darwinbeing/tesc/README.md

VESC – Open Source ESC
=============

This the Hardware for my open source custom ESC.

[//]: # (Image References)
[image1]: design/PNGs/VESC_6_top.png "MB Front"
[image2]: design/PNGs/VESC_6_bottom.png "MB Back"

## 3D views
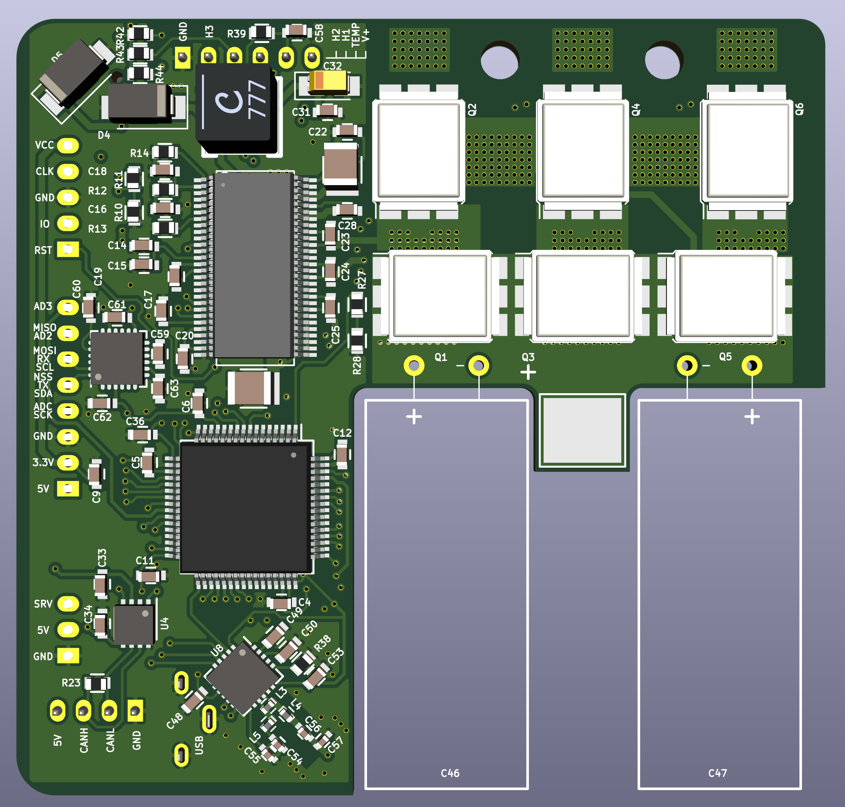
[picture p1: design/PNGs/VESC_6_top.png]

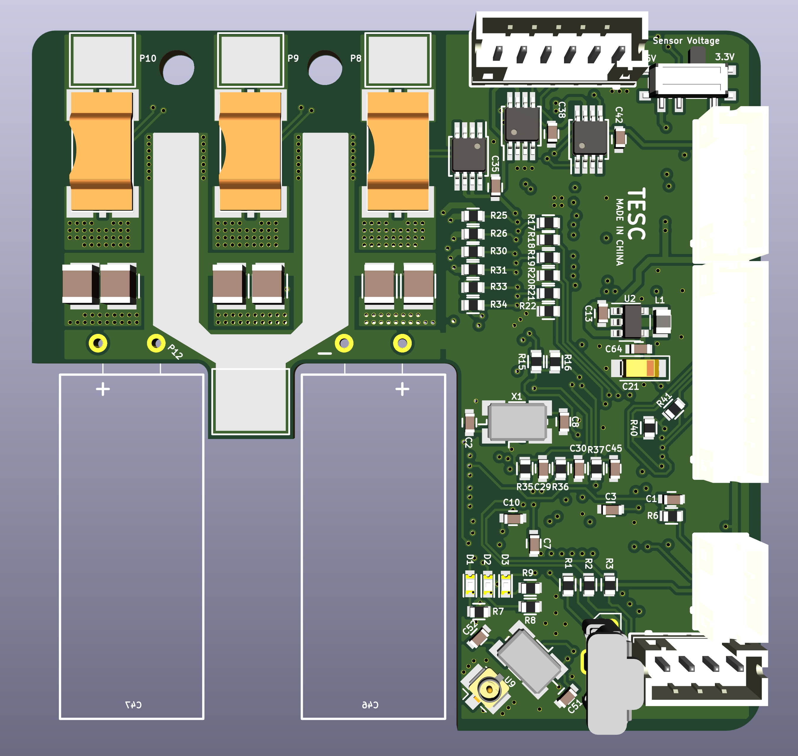
[picture p2: design/PNGs/VESC_6_bottom.png]
