darwinbeing/tesc/design/PNGs/VESC_6_plus_bottom.png

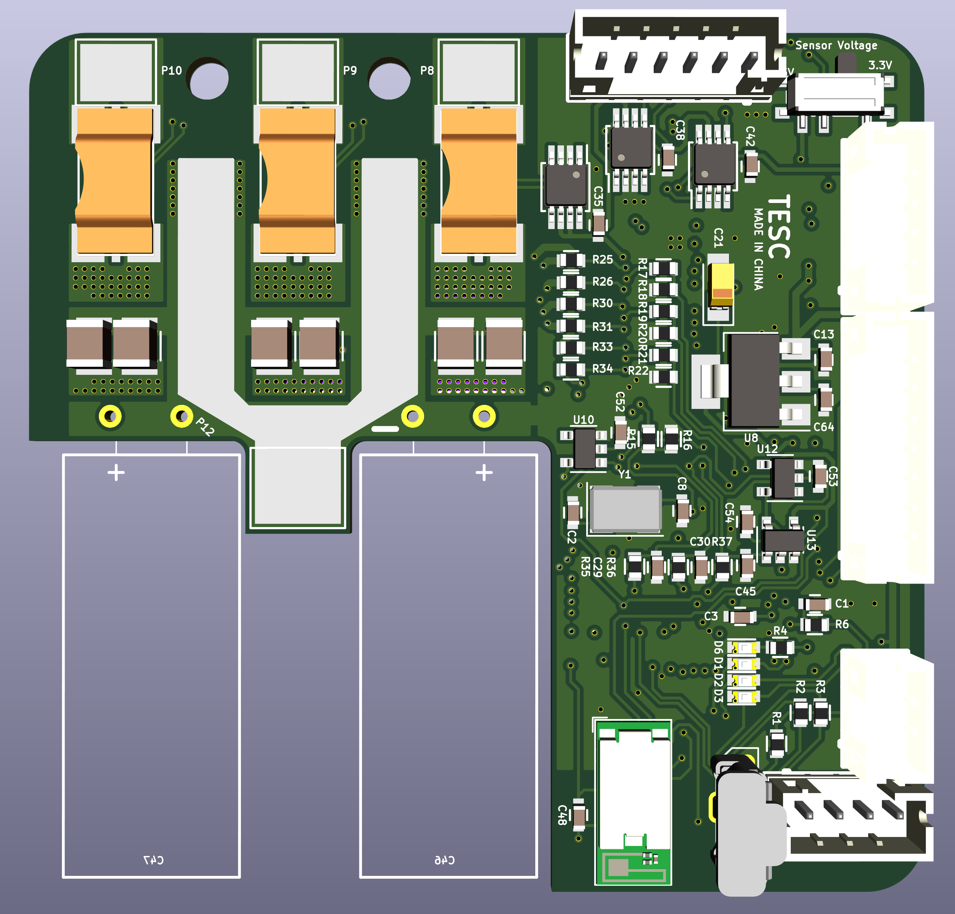
design/PNGs/VESC_6_plus_bottom.png
