darwinbeing/tesc/design/PNGs/VESC_6_plus_top.png

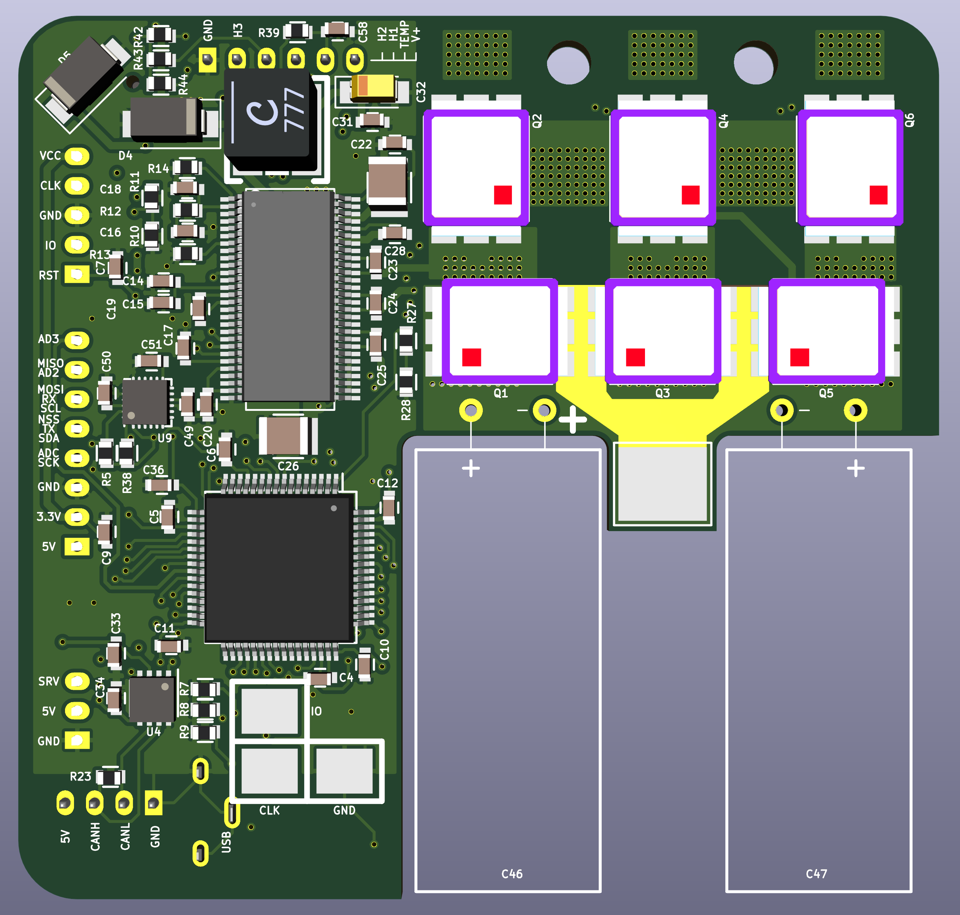
design/PNGs/VESC_6_plus_top.png
