darwinbeing/tesc/design/TESC Bill of Materials.xlsx

Reference | Value | Package | Description | Qty | Digikey | Mouser | Farnell | Arrow | Part Number |  | Place (YES/MotionTracking/Wireless)
U1 |  | LQFP-64 | STM32F4 MCU | 1 | 497-11767-ND | 511-STM32F405RGT6 | 2064363 | STM32F405RGT6 (https://www.arrow.com/en/products/stm32f405rgt6/stmicroelectronics) | STM32F405RGT6 |  | YES
U2 |  | SOT-23 | VREG LM3671 | 1 | LM3671MF-3.3/NOPBCT-ND | 926-LM3671MF-3.3NOPB | 1685767 | LM3671MF-3.3/NOPB (https://www.arrow.com/en/products/lm3671mf-3.3nopb/texas-instruments) | LM3671MF-3.3/NOPB |  | YES
U3 |  | HTSSOP-56-PP | MOSFET Driver DRV8301 | 1 | 296-33274-5-ND | 595-DRV8301DCA | 2057084 | DRV8301DCA (https://www.arrow.com/en/products/drv8301dca/texas-instruments) | DRV8301DCA |  | YES
U4 |  |  | CAN Trans TJA1051TK3 | 1 | 568-8686-1-ND | 771-TJA1051TK/3118 | 2776121 | TJA1051TK/3/1J (https://www.arrow.com/en/products/tja1051tk31j/nxp-semiconductors) | TJA1051TK/3/1J |  | YES
U5,U6,U7 |  | SOIC-8 | AD8418 | 3 | AD8418AWBRMZ-RLCT-ND | 584-AD8418AWBRMZ | 2383471 | AD8418AWBRMZ-RL (https://www.arrow.com/en/products/ad8418awbrmz-rl/analog-devices) | AD8418AWBRMZ |  | YES
U8 |  |  | nRF24L01+ | 1 | 1490-1019-ND | 949-NRF24L01P-T | 2842317 | NRF24L01P-T (https://www.arrow.com/en/products/nrf24l01p-t/nordic-semiconductor) | NRF24L01P-T | NRF24L01P-R7 | Wireless
U9 |  |  | CONN U FL antenna connector | 2 | H122041-ND | 798-UFLRSMT140 | 1688077 | U.FL-R-SMT-1(40) (https://www.arrow.com/en/products/u.fl-r-smt-1-40/hirose-electric) | U.FL-R-SMT-1(40) |  | Wireless
U10 |  |  | MPU9250 9-axis sensor | 1 | 1428-1019-1-ND | 410-MPU-9250 |  |  | MPU-9250 |  | MotionTracking
R27 |  | SM0603 | NTC resistor (temp sensor) | 1 | 490-4800-1-ND | 81-NCP18XH103F03RB | 2456122RL | NCP18XH103F03RB (https://www.arrow.com/en/products/ncp18xh103f03rb/murata-manufacturing) | NCP18XH103F03RB |  | YES
L1 | 2.2u | SMD0805 |  | 1 | 490-9573-1-ND |  |  | LQM21PN2R2MGHL (https://www.arrow.com/en/products/lqm21pn2r2mghl/murata-manufacturing) | LQM21PN2R2MGHL |  | YES
L2 | 22u | inductor_smd_8x8mm | Power Inductor | 1 | 732-3034-1-ND |  |  | SDR0805-220ML (https://www.arrow.com/en/products/sdr0805-220ml/bourns) | SDR0805-220ML | or SRN8040TA-220M | YES
L3 | 8.2n | SMD-0603 |  | 1 | 490-1109-1-ND |  |  | LQG18HN8N2J00D (https://www.arrow.com/en/products/lqg18hn8n2j00d/murata-manufacturing) | LQG18HN8N2J00D |  | Wireless
L4 | 3.9n | SMD-0603 |  | 1 | 490-1105-1-ND |  |  | LQG18HN3N9S00D (https://www.arrow.com/en/products/lqg18hn3n9s00d/murata-manufacturing) | LQG18HN3N9S00D |  | Wireless
L5 | 2.7n | SMD-0603 |  | 1 | 490-1103-1-ND |  |  | LQG18HN2N7S00D (https://www.arrow.com/en/products/lqg18hn2n7s00d/murata-manufacturing) | LQG18HN2N7S00D |  | Wireless
X1 | 8MHz |  | Crystal 8MHz, 10PPM | 1 | 535-9721-1-ND | 815-ABM3B-8.0-10-1UT |  | ABM3B-8.000MHZ-10-1-U-T (https://www.arrow.com/en/products/abm3b-8.000mhz-10-1-u-t/abracon) | ABM3B-8.000MHZ-10-1-U-T |  | YES
X2 | 16MHz |  | Crystal 16Mhz | 1 | 300-8206-1-ND | 815-ABM3B-16-T |  | ABM3B-16.000MHZ-10-1-U-T (https://www.arrow.com/en/products/abm3b-16.000mhz-10-1-u-t/abracon) | ABM3B-16.000MHZ-10-1-U-T |  | Wireless
Q1-Q6 |  | DIRECTFET L8 |  | 6 | IRF7749L2TRPBFCT-ND | 942-IRF7749L1TRPBF | 2725913 | IRF7749L1TRPBF (https://www.arrow.com/en/products/irf7749l1trpbf/infineon-technologies-ag) | IRF7749L1TRPBF | or IRF7749L2TRPBF | YES
R24,R29,R32 | 0.5mOhm |  | Shunt 0.5mOhm | 3 |  | 652-CSS2H3920RL500FE |  | CSS2H-3920R-L500FE (https://www.arrow.com/en/products/css2h-3920r-l500fe/bourns) | CSS2H-3920R-L500FE |  | YES
D5 | 5V | DO-214AC | TVS diode 5V | 1 |  | 576-SMAJ5.0A |  | SMAJ5.0A (https://www.arrow.com/en/products/smaj5.0a/littelfuse) | SMAJ5.0A |  | YES
D4 | 60V 2A | DO-214AA(SMB) | Shottky 60V 2A | 1 |  | 771-PMEG6020ER-115 |  | PMEG6020ER,115 (https://www.arrow.com/en/products/pmeg6020er115/nexperia) | PMEG6020ER,115 |  | YES
C1 C7 C28 C48 C49 C50 C53 C58 C60 | 100nF | Capacitors_SMD:C_0603 | 100nF 50V X7R 0603 | 9 | 478-5778-1-ND | 581-06035C104JAT2A | 1740621RL | 06035C104JAT2A (https://www.arrow.com/en/products/06035c104jat2a/avx) | 06035C104JAT2A
C2 C8 C51 C52 | 15pF | Capacitors_SMD:C_0603 | 15pF 100V C0G 0603 | 4 | 311-1749-1-ND | 603-CC603JRNPO0BN150 |  |  | CC0603JRNPO0BN150
C3 C4 C5 C6 C9 C10 C11 C12 C13 C14 C15 C17 C20 C31 C33 C34 C35 C36 C38 C42 C59 C61 C62 C63 C64 | 2.2uF | Capacitors_SMD:C_0603 | 2.2uF 16V X5R 0603 | 25 |  | 810-C1608X5R1C225M-4
C16 | 6.8nF | Capacitors_SMD:C_0603 | 6.8nF 50V X7R 0603 | 1 |  | 81-GRM18R71H682KA01J |  |  | GRT188R71H682KE01D
C18 | 120nF | Capacitors_SMD:C_0603 | 120nF 50V X7R 0603 | 1 |  | 81-GRM39C121J50 |  |  | GRM1885C1H121JA01D
C19 | 22nF | Capacitors_SMD:C_0603 | 22nF 50V X7R 0603 | 1 |  | 81-GCJ188L81H223KA1D
C21,C32 | 100uF, 6.3V | c_tant_B 1210 | CAP 100u, 6.3V | 2 |  | 581-TPSB107K006R0400 | 1432579 | TPSB107K006R0400 (https://www.arrow.com/en/products/tpsb107k006r0400/avx) | TPSB107K006R0400 |  | YES
C37,C39,C40,C41,C43,C44,C26,C27 | 4.7uF 100V | SMD1210 | CAP 4.7u, 100V, 1210 | 8 |  |  |  | C3225X7S2A475K200AB (https://www.arrow.com/en/products/c3225x7s2a475k200ab/tdk) | C3225X7S2A475K200AB |  | YES
C1,C7,C28,C58 | 100nF, 50V | SMD-0603 | CAP 100n, 50V, 0603 | 4 |  |  |  | 06035C104JAT2A (https://www.arrow.com/en/products/06035c104jat2a/avx) | 06035C104JAT2A |  | YES
C48,C49,C50,C53 | 100nF, 50V | SMD-0603 | CAP 100n, 50V, 0603 | 4 |  |  |  | 06035C104JAT2A (https://www.arrow.com/en/products/06035c104jat2a/avx) | 06035C104JAT2A |  | Wireless
C23,C24,C25 | 220nF,25V | SMD-0603 | CAP 220n, 25V, 0603 | 3 |  |  |  | CL10B224KA8NNNC (https://www.arrow.com/en/products/cl10b224ka8nnnc/samsung-electro-mechanics) | CL10B224KA8NNNC |  | YES
C3-C6,C9,C10,C11,C12,C13,C14,C15,C17,C20,C31,C33,C34,C35,C36,C38,C42,C64 | 2.2uF, 16V | SMD-0603 | CAP 2.2u, 16V, 0603 | 21 |  |  |  | CL10A225KO8NNNC (https://www.arrow.com/en/products/cl10a225ko8nnnc/samsung-electro-mechanics) | CL10A225KO8NNNC |  | YES
C59,C61,C62 | 2.2uF, 16V | SMD-0603 | CAP 2.2u, 16V, 0603 | 3 |  |  |  | CL10A225KO8NNNC (https://www.arrow.com/en/products/cl10a225ko8nnnc/samsung-electro-mechanics) | CL10A225KO8NNNC |  | MotionTracking
C29,C30,C45 | 4.7nF, 50V | SMD-0603 | CAP 4.7n, 50V, 0603 | 3 |  |  |  | GRM188R71H472JA01J (https://www.arrow.com/en/products/grm188r71h472ja01j/murata-manufacturing) | GRM188R71H472JA01J |  | YES
C54 | 2.2nF, 50V | SMD-0603 | CAP 2.2n, 50V, 0603 | 1 |  |  |  | GRM188R71H222JA01D (https://www.arrow.com/en/products/grm188r71h222ja01d/murata-manufacturing) | GRM188R71H222JA01D |  | Wireless
C2,C8 | 15pF, 100V | SMD-0603 | CAP 15p, 100V, 0603 | 2 |  |  |  | CC0603JRNPO0BN150 (https://www.arrow.com/en/products/cc0603jrnpo0bn150/yageo) | CC0603JRNPO0BN150 |  | YES
C51,C52 | 15pF, 100V | SMD-0603 | CAP 15p, 100V, 0603 | 2 |  |  |  | CC0603JRNPO0BN150 (https://www.arrow.com/en/products/cc0603jrnpo0bn150/yageo) | CC0603JRNPO0BN150 |  | Wireless
C18 | 120pF, 50V | SMD-0603 | CAP 120p, 50V, 0603 | 1 |  |  |  | GRM1885C1H121GA01D (https://www.arrow.com/en/products/grm1885c1h121ga01d/murata-manufacturing) | GRM1885C1H121GA01D |  | YES
C16 | 6.8nF, 50V | SMD-0603 | CAP 6.8n, 50V, 0603 | 1 |  |  |  | GRT188R71H682KE01D (https://www.arrow.com/en/products/grt188r71h682ke01d/murata-manufacturing) | GRT188R71H682KE01D |  | YES
C19 | 22nF, 50V | SMD-0603 | CAP 22n, 50V, 0603 | 1 |  |  |  | GRM188F51H223ZA01D (https://www.arrow.com/en/products/grm188f51h223za01d/murata-manufacturing) | GRM188F51H223ZA01D |  | YES
C22 | 15n, | SMD-0603 | CAP 15n, | 1 |  |  |  | VJ0603Y153KXACW1BC (https://www.arrow.com/en/products/vj0603y153kxacw1bc/vishay) | VJ0603Y153KXACW1BC |  | YES
C46,C47 | 680u, 63V | 30x12.5 mm | CAP 680u, 63V, | 2 |  | 661-EKZN630E681MK30S |  | EKZN630E681MK30S | EKZN630E681MK30S |  | YES
C55 | 4.7pF | SMD-0603 |  | 1 |  |  |  | CL10C4R7CB8NNND (https://www.arrow.com/en/products/cl10c4r7cb8nnnd/samsung-electro-mechanics) | CL10C4R7CB8NNND | solder on top of C54 | Wireless
C56 | 1.5pF | SMD-0603 |  | 1 |  |  |  | CL10C1R5BB8NNNC (https://www.arrow.com/en/products/cl10c1r5bb8nnnc/samsung-electro-mechanics) | CL10C1R5BB8NNNC |  | Wireless
C57 | 1pF | SM0603 |  | 1 |  |  |  | CL10C010BB8NNND (https://www.arrow.com/en/products/cl10c010bb8nnnd/samsung-electro-mechanics) | CL10C010BB8NNND |  | Wireless
D3 |  | SMD-0603 | LED Green, 0603 | 1 |  |  |  | VLMTG1300-GS08 (https://www.arrow.com/en/products/vlmtg1300-gs08/vishay) | VLMTG1300-GS08 |  | YES
D2 |  | SMD-0603 | LED Red, 0603 | 1 |  |  |  | VLMS1300-GS08 (https://www.arrow.com/en/products/vlms1300-gs08/vishay) | VLMS1300-GS08 |  | YES
D1 |  | SMD-0603 | LED Blue, 0603 | 1 |  |  |  | VLMB1300-GS08 (https://www.arrow.com/en/products/vlmb1300-gs08/vishay) | VLMB1300-GS08 |  | YES
R25,R26,R30,R31,R33,R34 | 4.7ohm | SMD-0603 | R 4.7ohm, 0603 | 6 |  |  |  | RK73H1JTTD4R70F (https://www.arrow.com/en/products/rk73h1jttd4r70f/koa-speer-electronics) | RK73H1JTTD4R70F |  | YES
R6,R35,R36,R37 | 100ohm | SMD-0603 | R 100ohm, 0603 | 4 |  |  |  | RK73H1JTTDD1000F (https://www.arrow.com/en/products/rk73h1jttdd1000f/koa-speer-electronics) | RK73H1JTTDD1000F |  | YES
R8,R9,R23 | 220 Ohm | SMD-0603 | R 220, 0603 | 3 |  |  |  | RK73H1JTTD2200F (https://www.arrow.com/en/products/rk73h1jttd2200f/koa-speer-electronics) | RK73H1JTTD2200F |  | YES
R7,R40,R41 | 1k Ohm | SMD-0603 | R 1k, 0603 | 3 |  |  |  | RK73H1JTTD1001F (https://www.arrow.com/en/products/rk73h1jttd1001f/koa-speer-electronics) | RK73H1JTTD1001F |  | YES
R16,R18,R20,R22,R42,R43,R44 | 2.2kOhm | SMD-0603 | R 2.2k, 0603 | 7 |  |  |  | RK73H1JTTD2201F (https://www.arrow.com/en/products/rk73h1jttd2201f/koa-speer-electronics) | RK73H1JTTD2201F |  | YES
R10 | 3.3kOhm | SMD-0603 | R 3.3k, 0603 | 1 |  |  |  | RMCF0603FT3K30 (https://www.arrow.com/en/products/rmcf0603ft3k30/stackpole-electronics) | RMCF0603FT3K30 |  | YES
R13,R28,R39 | 10kOhm | SMD-0603 | R 10k, 0603 | 3 |  |  |  | RK73H1JTTP1002F (https://www.arrow.com/en/products/rk73h1jttp1002f/koa-speer-electronics) | RK73H1JTTP1002F |  | YES
R12 | 15kOhm | SMD-0603 | R 15k, 0603 | 1 |  |  |  | ERJ-3EKF1502V (https://www.arrow.com/en/products/erj-3ekf1502v/panasonic) | ERJ-3EKF1502V |  | YES
R11 | 18kOhm | SMD-0603 | R 18k, 0603 | 1 |  |  |  | RK73H1JTTD1802F (https://www.arrow.com/en/products/rk73h1jttd1802f/koa-speer-electronics) | RK73H1JTTD1802F |  | YES
R38 | 22kOhm | SMD-0603 | R 22k, 0603 | 1 |  |  |  | RC0603FR-0722KL (https://www.arrow.com/en/products/rc0603fr-0722kl/yageo) | RC0603FR-0722KL |  | Wireless
R15,R17,R19,R21 | 39kOhm | SMD-0603 | R 39k, 0603 | 4 |  |  |  | RK73H1JTTD3902F (https://www.arrow.com/en/products/rk73h1jttd3902f/koa-speer-electronics) | RK73H1JTTD3902F |  | YES
R14 | 220kOhm | SMD-0603 | R 220k, 0603 | 1 |  |  |  | RK73H1JTTD2203F (https://www.arrow.com/en/products/rk73h1jttd2203f/koa-speer-electronics) | RK73H1JTTD2203F |  | YES
R2, R3 | 22ohm | SMD-0603 | R 22R, 0603 | 2 |  |  |  | RK73H1JTTD22R0F (https://www.arrow.com/en/products/rk73h1jttd22r0f/koa-speer-electronics) | RK73H1JTTD22R0F |  | YES
R1 | 0Ohm | SMD-0603 | R 0R, 0603 | 1 |  |  |  | RC1608J000CS (https://www.arrow.com/en/products/rc1608j000cs/samsung-electro-mechanics) | RC1608J000CS |  | YES
P1 |  | USB | USB Connectors 5P MICRO USB TYPE B RECEPTACLE | 1 |  | 538-105133-0001 | 2630075 | 1051330001 (https://www.arrow.com/en/products/1051330001/molex) | 1051330001 |  | YES
P7 |  | MICRO_JST_5 | Micro-JST 5PIN 2mm | 1 |  |  | 9492445 | B5B-PH-K-R (LF)(SN) (https://www.arrow.com/en/products/b5b-ph-k-r-lf-sn/jst-manufacturing) | B5B-PH-K-R (LF)(SN) |  | YES
P6 |  | MICRO_JST_3 | Micro-JST 3PIN 2mm | 1 |  |  | 9492429 | B3B-PH-K-S (LF)(SN) (https://www.arrow.com/en/products/b3b-ph-k-s-lf-sn/jst-manufacturing) | B3B-PH-K-S (LF)(SN) |  | YES
P5 |  | MICRO_JST_8 | Micro-JST 8PIN 2mm | 1 |  |  | 9492461 | B8B-PH-K-S (LF)(SN) (https://www.arrow.com/en/products/b8b-ph-k-s-lf-sn/jst-manufacturing) | B8B-PH-K-S (LF)(SN) |  | YES
P4 |  | MICRO_JST_6 | Micro-JST 6PIN 2mm | 1 |  |  | 9492453 | B6B-PH-K-S (LF)(SN) (https://www.arrow.com/en/products/b6b-ph-k-s-lf-sn/jst-manufacturing) | B6B-PH-K-S (LF)(SN) |  | YES
P2 |  | MICRO_JST_4 | Micro-JST 4PIN 2mm | 1 |  |  | 9492437 | B4B-PH-K-S (LF)(SN) (https://www.arrow.com/en/products/b4b-ph-k-s-lf-sn/jst-manufacturing) | B4B-PH-K-S (LF)(SN) |  | YES
P8 |  | SWITCH | SPDT on-on | 1 | 401-2016-1-ND | 611-PCM12SMTR |  | PCM12SMTR | PCM12SMTR |  | YES
