darwinbeing/tesc/design/OpenSCAD/USB_Relais_card_housing/Lid.stl

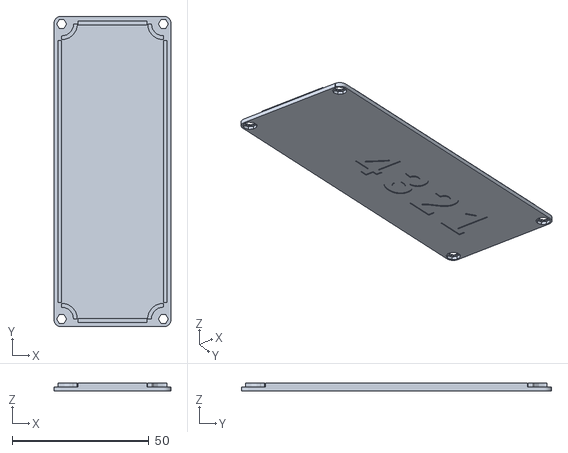
[picture p21: CAD file, 2018-06-15]
design/OpenSCAD/USB_Relais_card_housing/Lid.stl
42.8 x 113.5 x 2.80
