darwinbeing/tesc/design/OpenSCAD/VESC_6.stl

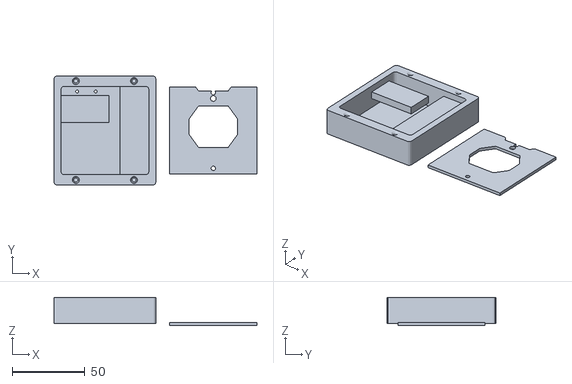
[picture p22: CAD file, 2018-06-18]
design/OpenSCAD/VESC_6.stl
139.5 x 74.8 x 19.3
