darwinbeing/tesc/design/OpenSCAD/USB_Relais_card_housing/Case.stl

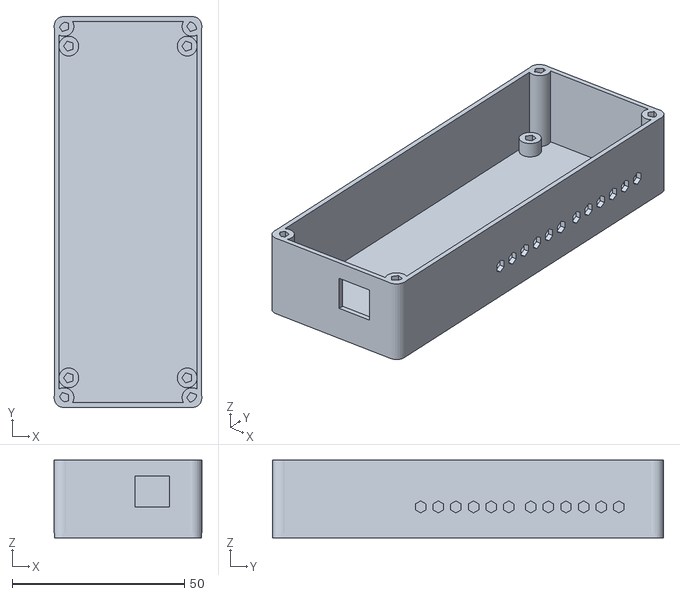
[picture p23: CAD file, 2018-06-15]
design/OpenSCAD/USB_Relais_card_housing/Case.stl
43.0 x 113.6 x 22.6
