darwinbeing/tesc/design/OpenSCAD/USB_Relais_card_housing/CaseAndLid.stl

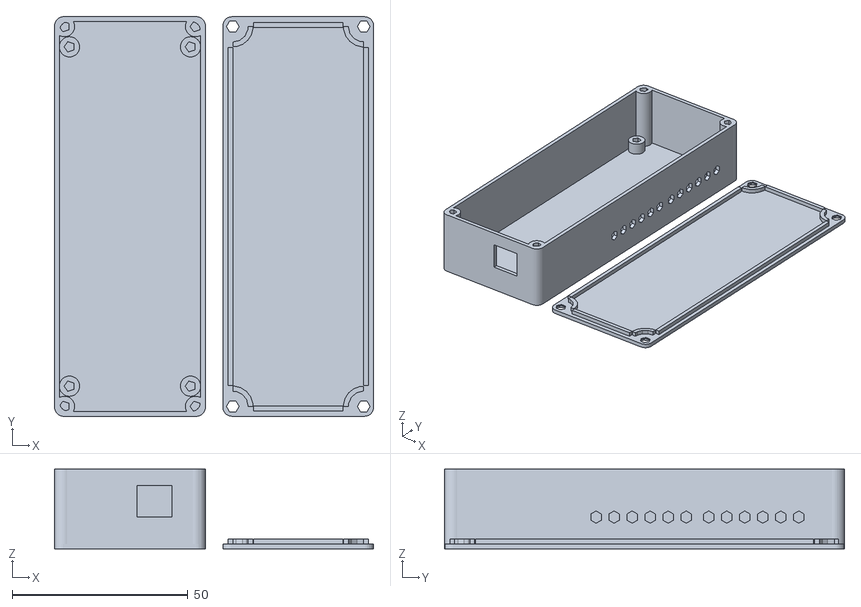
[picture p24: CAD file, 2018-06-15]
design/OpenSCAD/USB_Relais_card_housing/CaseAndLid.stl
90.7 x 113.6 x 22.6
