darwinbeing/tesc/design/OpenSCAD/USB_Relais_card_housing/polyhole.scad

module polyhole(h, d) 
{
	/* Nophead's polyhole code */
    n = max(round(2 * d),3);
    rotate([0,0,180])
        cylinder(h = h, r = (d / 2) / cos (180 / n), $fn = n);
}
