darwinbeing/tesc/(list of files, cad)

Other CAD files:
design/OpenSCAD/2016-04-23_FNQ220_Flix_v24.scad
design/OpenSCAD/2018-06-02_FNQ220_Flix_v39.scad
design/OpenSCAD/ElectricalBox.scad
design/OpenSCAD/USB_Relais_card_housing/roundCornersCube.scad
design/OpenSCAD/roundedcube.scad
design/OpenSCAD/screw_holes.scad
