darwinbeing/tesc/design/TESC_HandSoldering.xlsx

编号 | 参考编号 | 制造商编号 | 参考值 | 注释
1 | C1 C7 C28 C48 C49 C50 C53 C58 C60 | C0603X104J5RACTU | 100n
2 | C2 C8 C51 C52 | 06031A150JAT2A | 15p
3 | C3 C4 C5 C6 C9 C10 C11 C12 C13 C14 C15 C17 C20 C31 C33 C34 C35 C36 C38 C42 C61 C62 C64 | C1608X5R1C225K080AB | 2.2u
4 | C16 | GCD188R71H682KA01D | 6.8n
5 | C18 | GRM1885C1H121JA01D | 120p
6 | C19 | GCM188R71H223KA37J | 22n
7 | C21 C32 | TLJA107M006R0500 | 100u
8 | C22 | GCM188R71H153KA37D | 15n
9 | C23 C24 C25 | GCM188R71E224KA55D | 220n
10 | C26 C27 C37 C39 C40 C41 C43 C44 | CGA6M3X7S2A475K200AE | 4.7u_100V
11 | C29 C30 C45 | GRM188R71H472JA01J | 4.7n
12 | C46 C47 | EKZN630ELL681MK30S | 680u_63V
13 | C54 | GRM155R71H222JA01J | 2.2n
14 | C55 | GRM1555C2A4R7WA01D | 4.7p
15 | C56 | GRM1555C2A1R5CA01D | 1.5p
16 | C57 | GRM1555C2A1R0CA01D | 1p
17 | D1 | VLMB1300-GS08 | BLUE
18 | D2 | VLMS1300-GS08 | RED
19 | D3 | VLMTG1300-GS08 | GREEN
20 | D4 | SS26/B260-13-F/NTS260ESFT3G/PMEG6020ER,115 | DIODE
21 | D5 | SMAJ5.0A | TVS 5V
22 | L1 | 74479275222 | 2.2u
23 | L2 | XAL5050-223ME | 22u
24 | L3 | LQG18HN8N2J00D | 8.2n
25 | L4 | LQG18HN3N9S00D | 3.9n
26 | L5 | LQG18HN2N7S00D | 2.7n
27 | P1 | 1051330001 | USB_OTG
28 | P2 | B4B-PH-K-S (LF)(SN) | CAN
29 | P4 | B6B-PH-K-S (LF)(SN) | HALL_ENC
30 | P5 | B8B-PH-K-S (LF)(SN) | COM
31 | P6 | B3B-PH-K-S (LF)(SN) | SERVO
32 | P7 | B5B-PH-K-R (LF)(SN) | SWD
33 | Q1 Q2 Q3 Q4 Q5 Q6 | IRF7749L1TRPBF | IRF7749
34 | R1 | CR0603-J/-000EAS | 0R | 不焊接
35 | R2 R3 | CR0603-FX-22R0ELF | 22R
36 | R6 R35 R36 R37 | CR0603-FX-1000ELF | 100R
37 | R7 R40 R41 | CR0603-FX-1001ELF | 1k
38 | R8 R9 R23 | CR0603-FX-2200ELF | 220R
39 | R10 | CR0603-FX-3301ELF | 3.3k
40 | R11 | CRCW060318K0FKEA | 18k
41 | R12 | CRCW060315K0FKEB | 15k
42 | R13 R28 R39 | CR0603-FX-1002ELF | 10k
43 | R14 | ERJ-3EKF2203V | 220k
44 | R15 R17 R19 R21 | CR0603-FX-3902ELF | 39k
45 | R16 R18 R20 R22 R42 R43 R44 | CR0603-FX-2201ELF | 2k2
46 | R24 R29 R32 | CSS2H-3920R-L500FE | 0.0005R
47 | R25 R26 R30 R31 R33 R34 | CRCW06034R70FKEA | 4.7R
48 | R27 | NCP18XH103F03RB | NTC 10k
49 | R38 | CR0603-FX-2202ELF | 22k
50 | U1 | STM32F405RGT6 | STM32F40X_LQFP64
51 | U2 | LM3671MF-3.3/NOPB | LM3671
52 | U3 | DRV8301DCA | DRV8301
53 | U4 | TJA1051TK/3,118 | TJA1051TK3
54 | U5 U6 U7 | AD8418AWBRMZ | AD8418
55 | U8 | nRF24L01P-T | NRF24L01P
56 | U9 | U.FL-R-SMT-1(40) | CONN_U_FL
57 | U10 | MPU-9250 | MPU9250
58 | U11 | PCM12SMTR | SENSOR_VOLTAGE
59 | X1 | ABM3B-8.000MHZ-10-1-U-T | 8M
60 | X2 | ABM3B-16.000MHZ-10-1-U-T | 16M
