darwinbeing/tesc/design/VESC_4.pdf

Voltage supply (0 - 60v) Needs external decoupling
caps to avoid high voltage
transients produced by the

power ground in one place only

File: BLDC_4.sch Sheet: / Benjamin Vedder

Id: 1/7 Title: BLDC Driver 4.11


39k V_SUPPLY
File: mosfets.sch Sheet: /Power MOSFETS/ Benjamin Vedder R46

Id: 2/7 Title: BLDC Driver 4.11


Sheet: /NTC temp sensor/
File: temp.sch
Id: 3/7 Title: BLDC Driver 4.11


3 RXD 4 Vref 5 CANL 6 CANH 7 Rs 8 U401 SN65HVD232

File: CAN.sch Sheet: /CAN bus transceiver/ Benjamin Vedder

Id: 4/7 Title: BLDC Driver 4.11


Id: 5/7 Title: BLDC Driver 4.11


Id: 6/7 Title: BLDC Driver 4.11


MCU must sense the
voltage at each phase

File: Power.sch Sheet: /Mosfet driver/ Benjamin Vedder

Id: 7/7 Title: BLDC Driver 4.11
