darwinbeing/tesc/design/VESC_6_origin.pdf

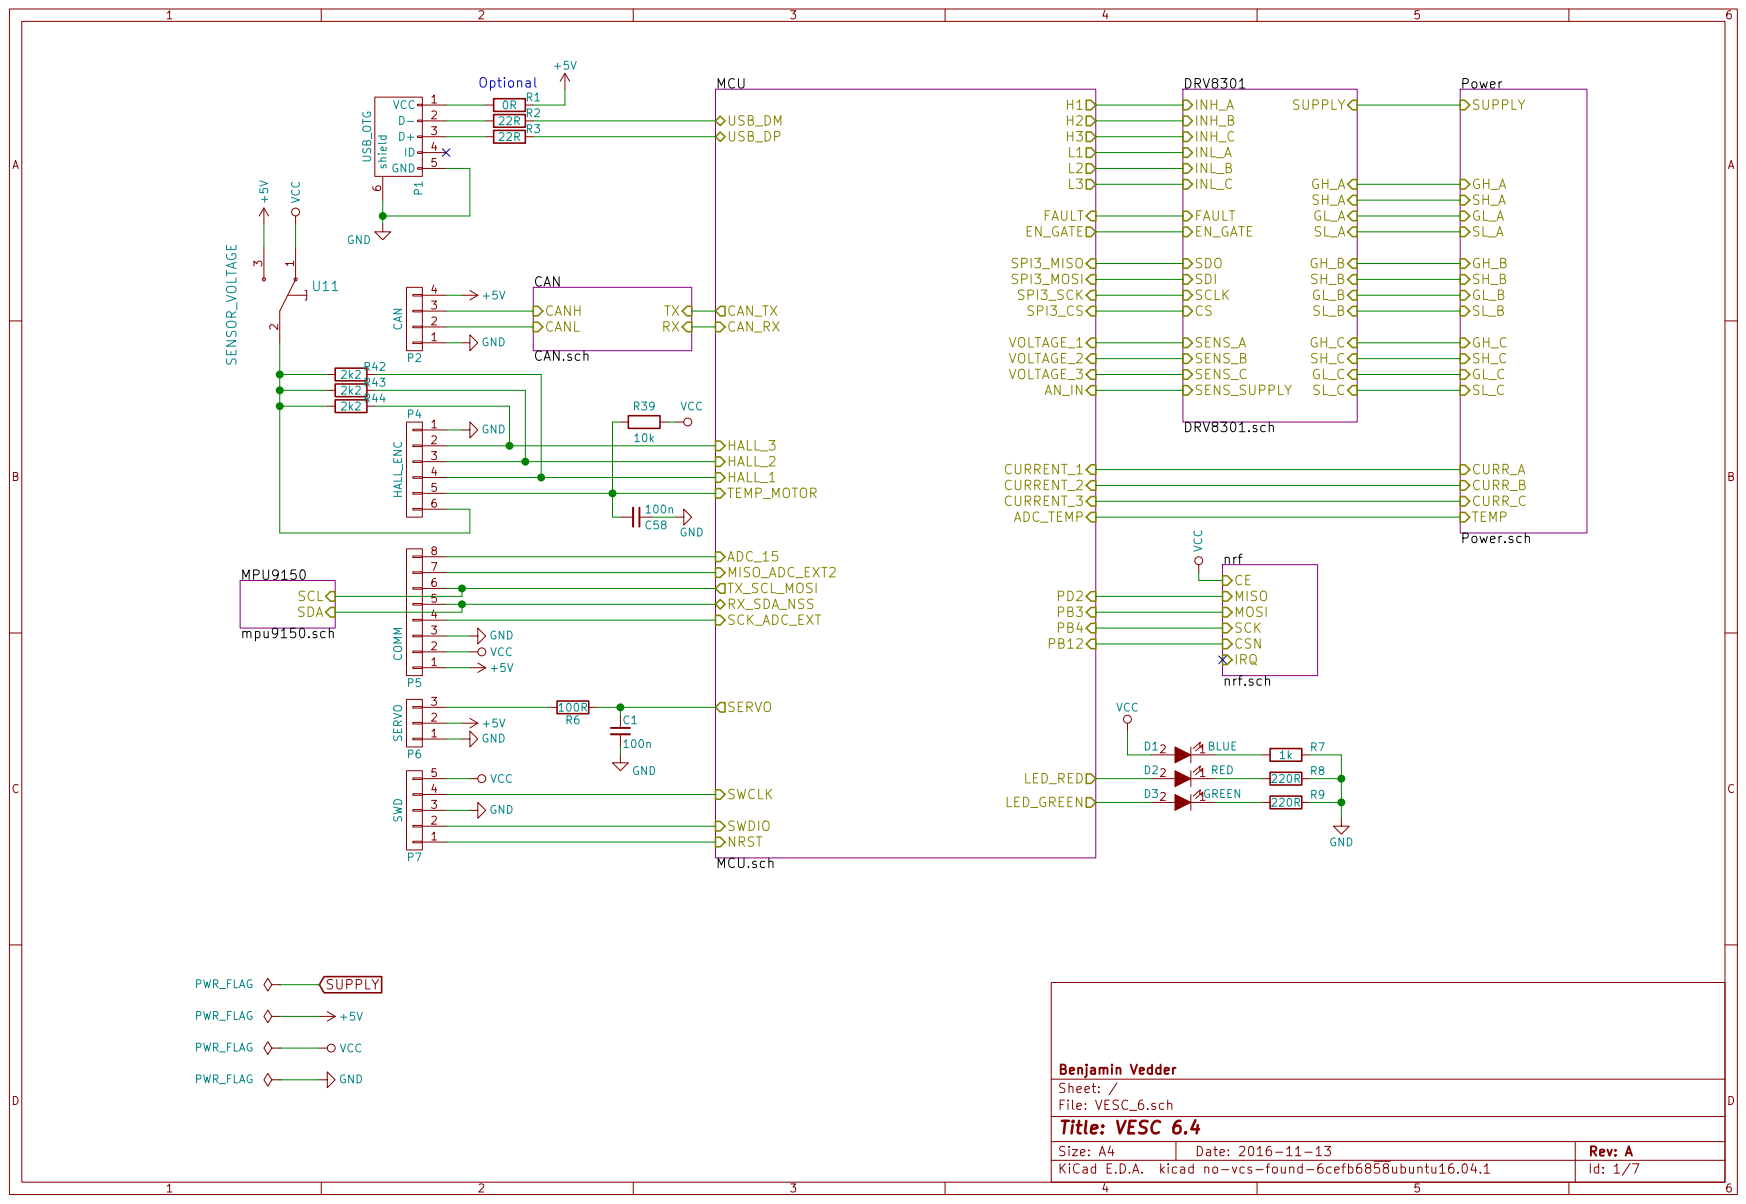
[picture p32: page 1]

KiCad E.D.A. kicad no-vcs-found-6cefb6858ubuntu16.04.1

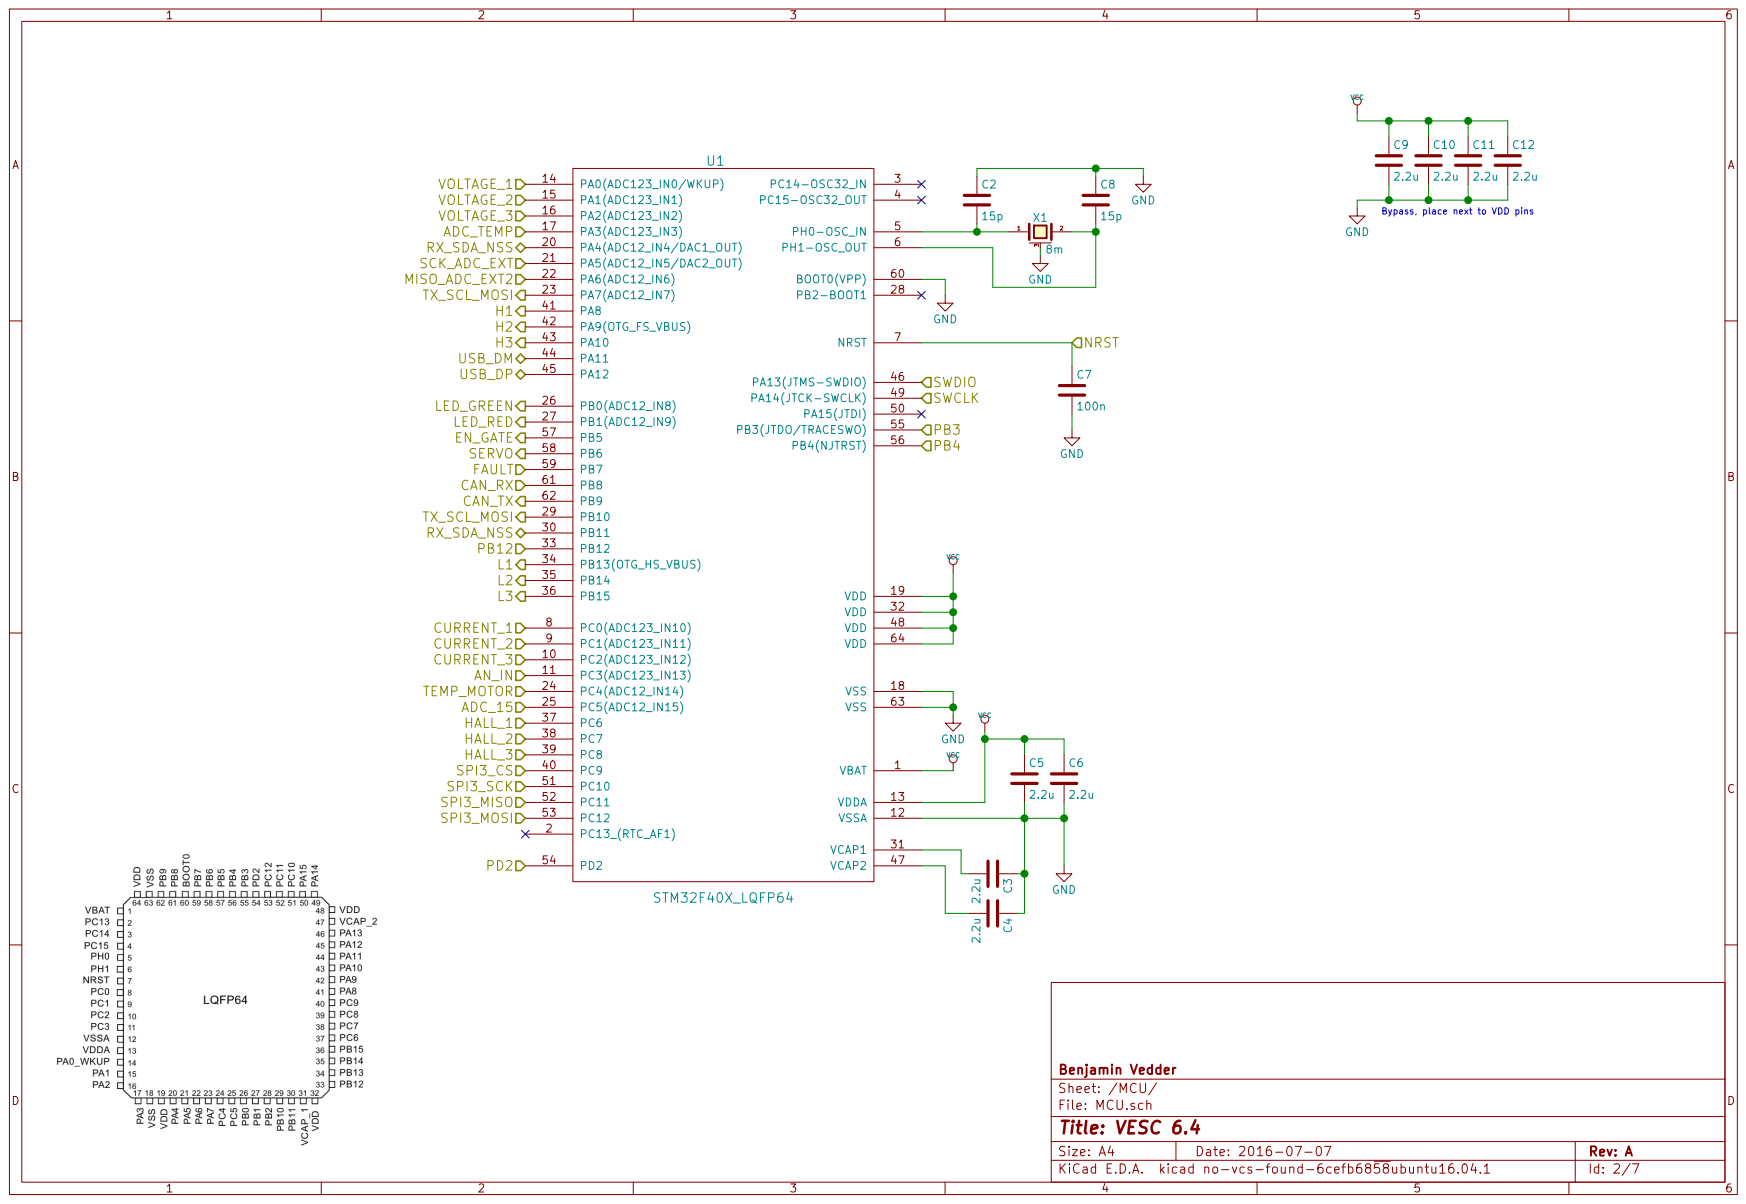
[picture p33: page 2]

Bypass, place next to VDD pins

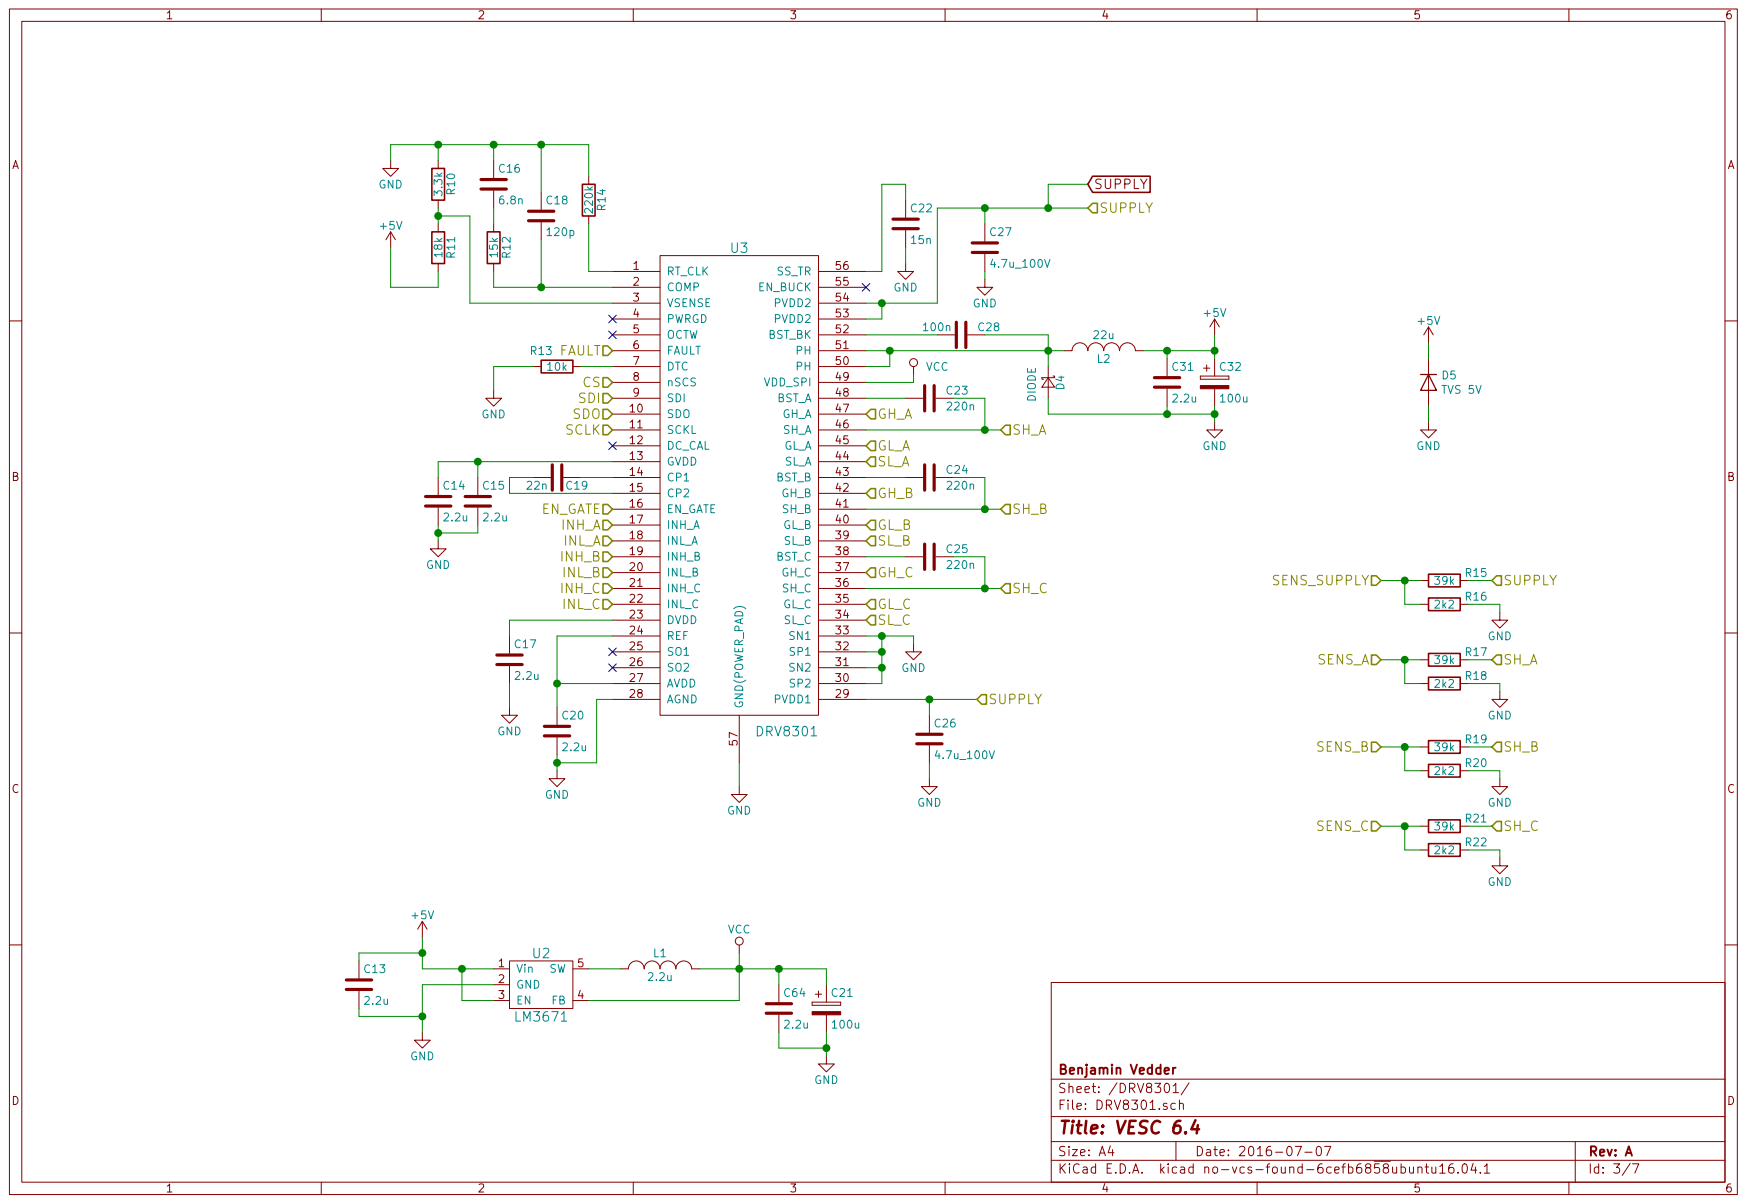
[picture p34: page 3]

EN_GATE 16 INH_A 17 INL_A 18 INH_B 19 INL_B 20 INH_C 21 INL_C 22 DVDD 23

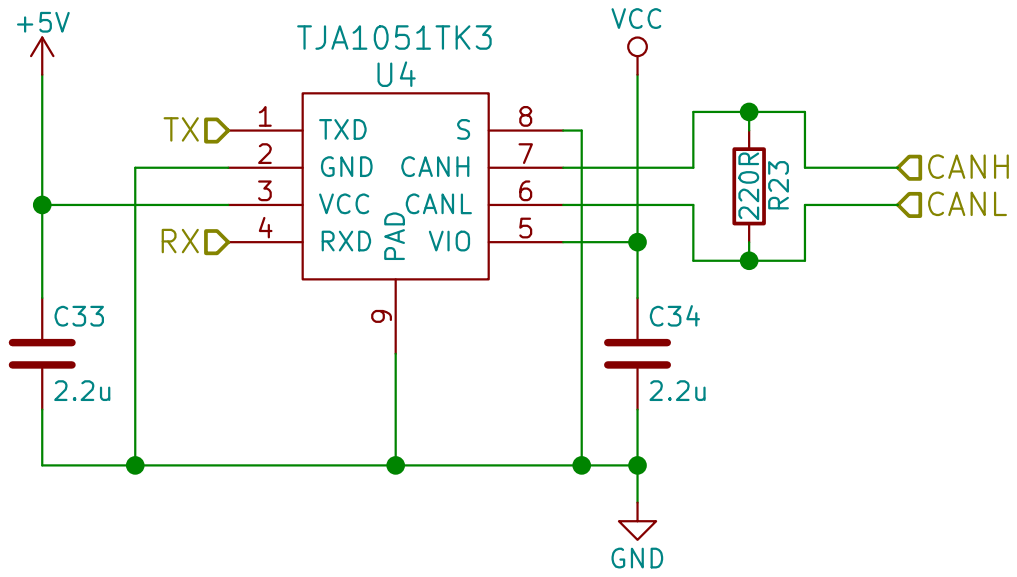
[picture p35: page 4]

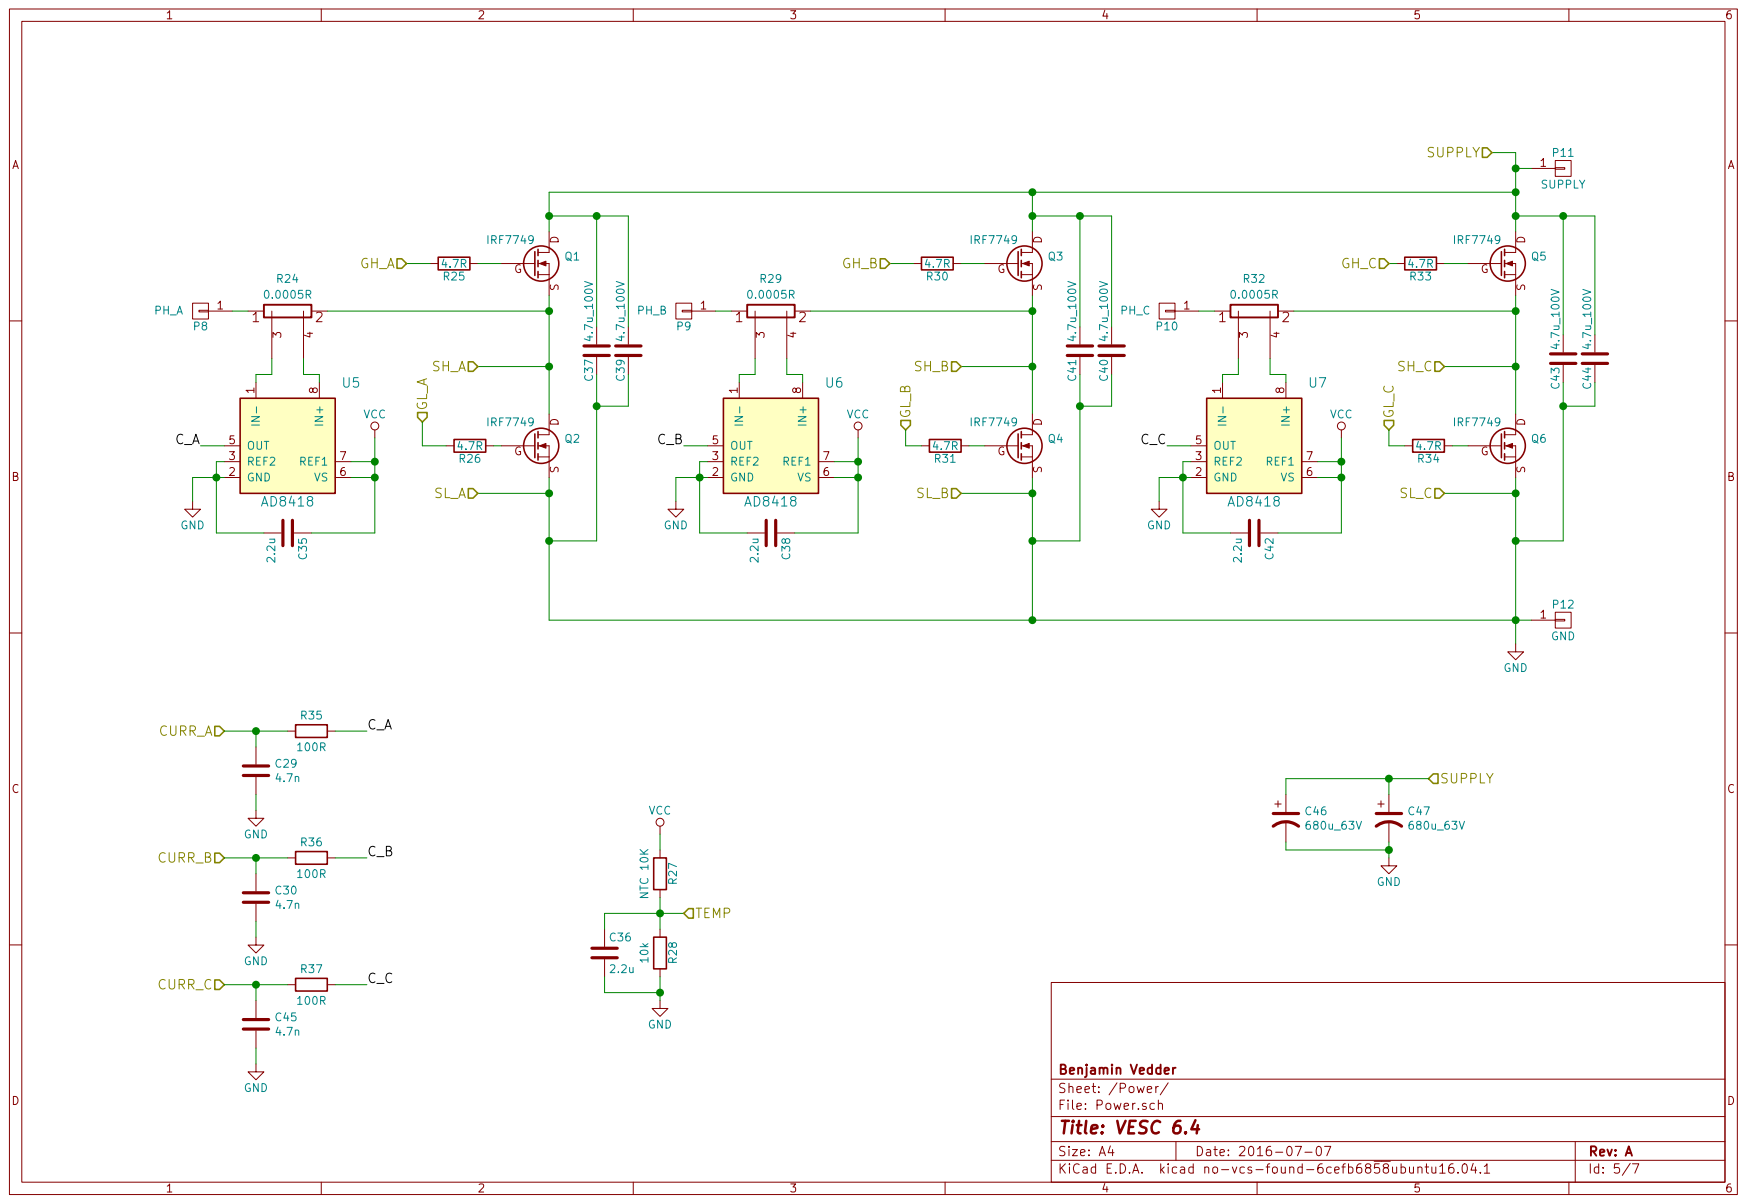
[picture p36: page 5]

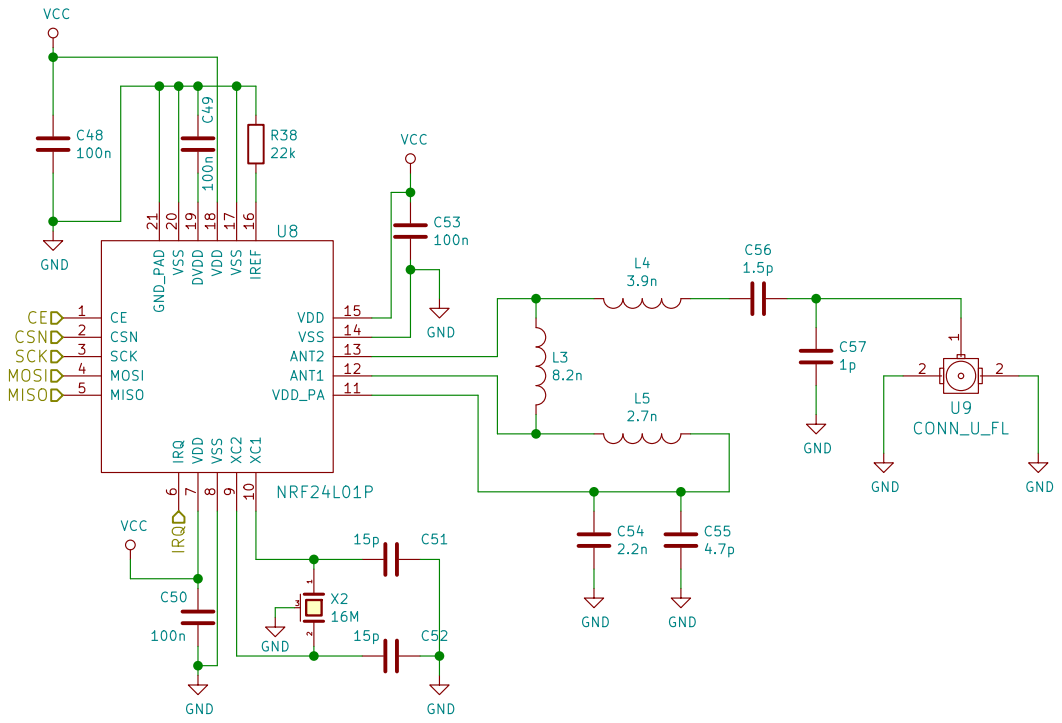
[picture p37: page 6]

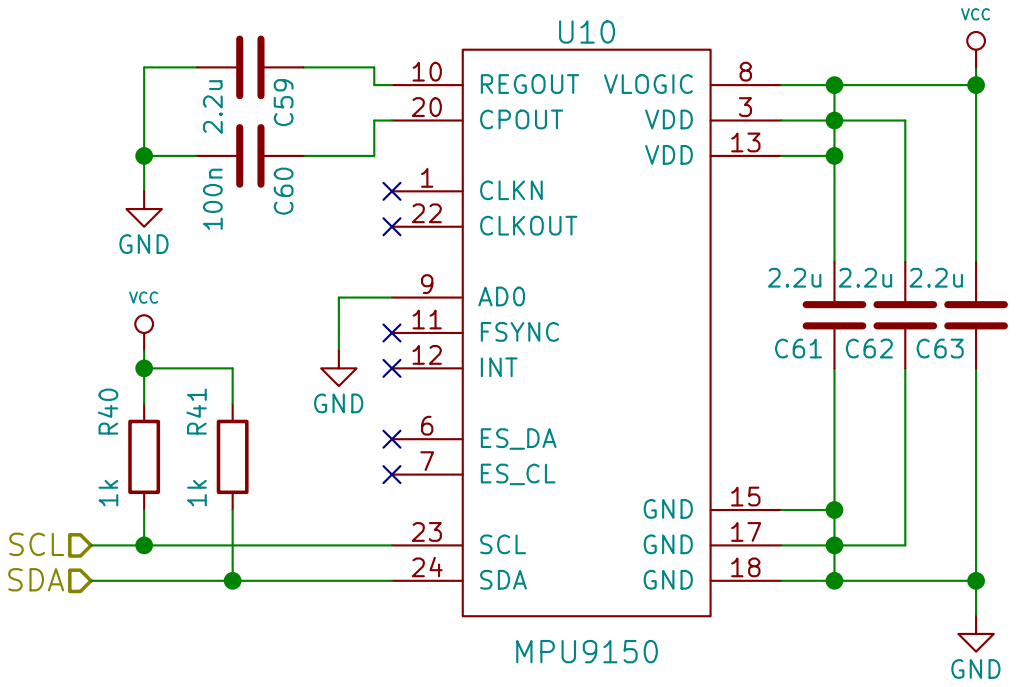
[picture p38: page 7]
