darwinbeing/tesc/design/pdf/VESC_6-B.SilkS.pdf

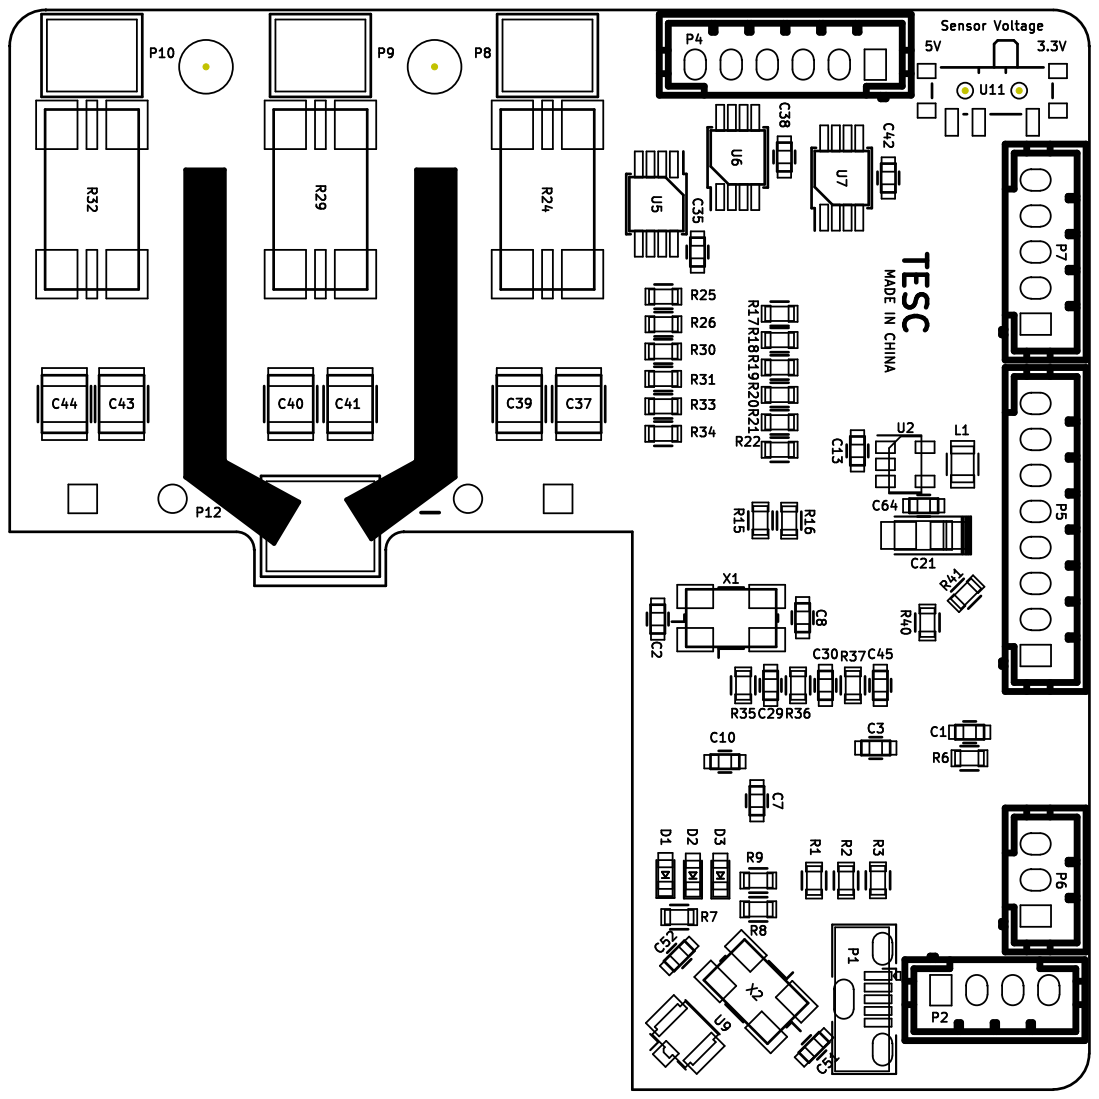
[picture p39: page 1]
