darwinbeing/tesc/design/pdf/VESC_6-F.SilkS.pdf

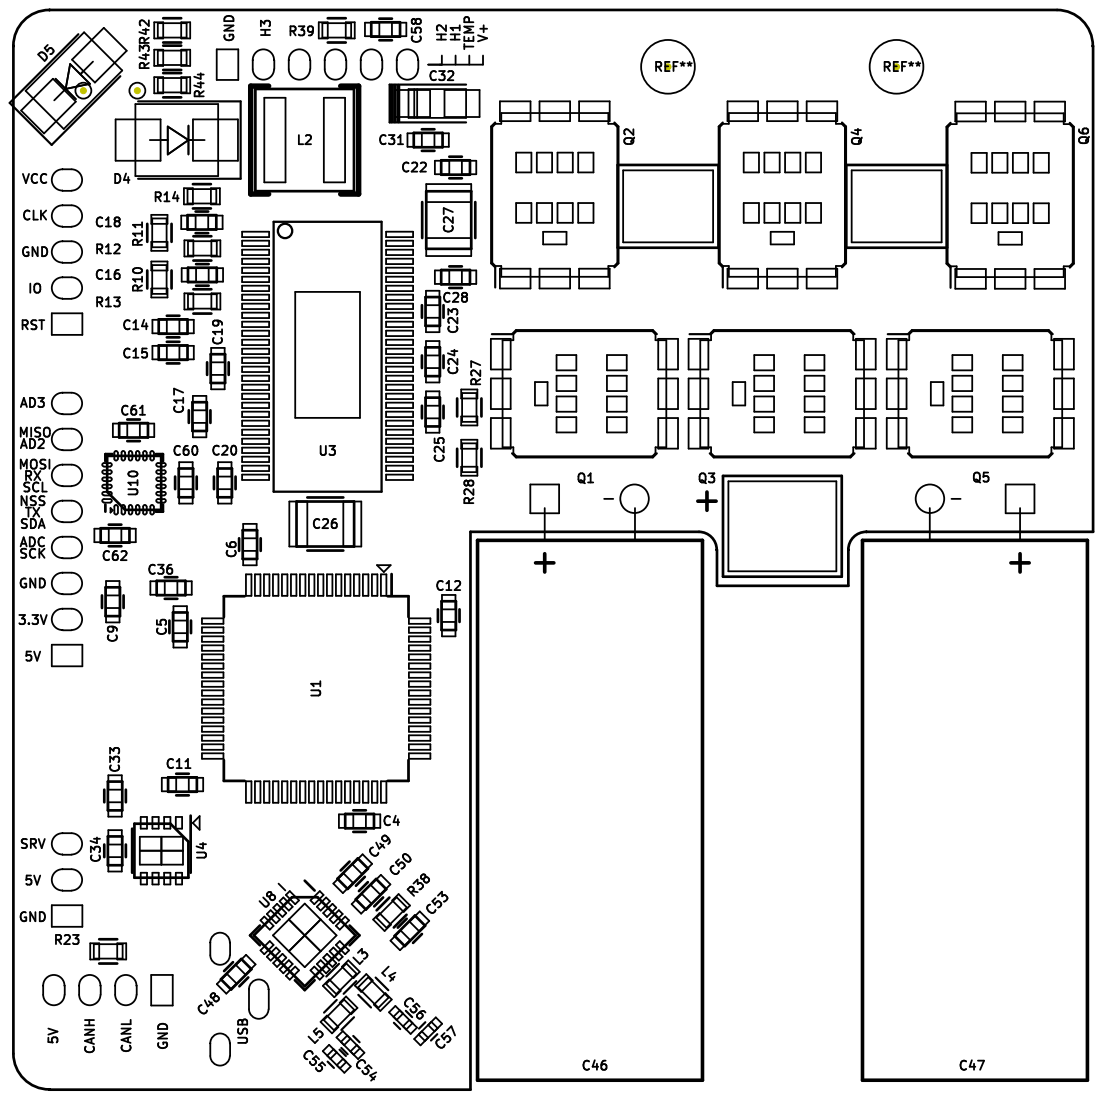
[picture p40: page 1]
