darwinbeing/tesc/design/VESC_6.kicad_pcb

## KiCad design design/VESC_6.kicad_pcb (2019-12-28)

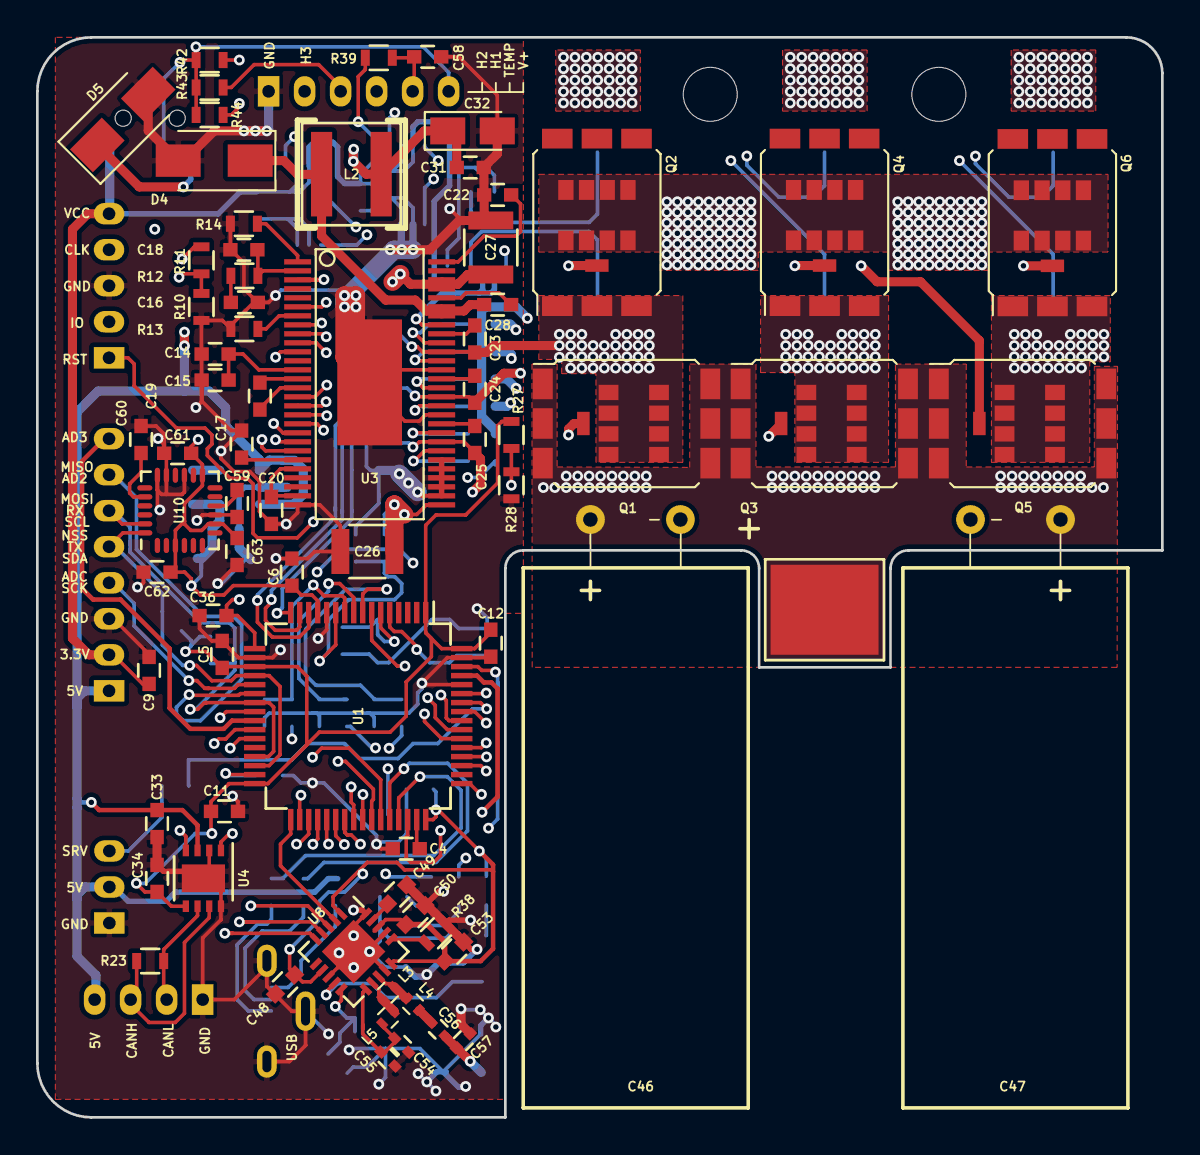
[picture p41: board VESC_6.kicad_pcb from above]

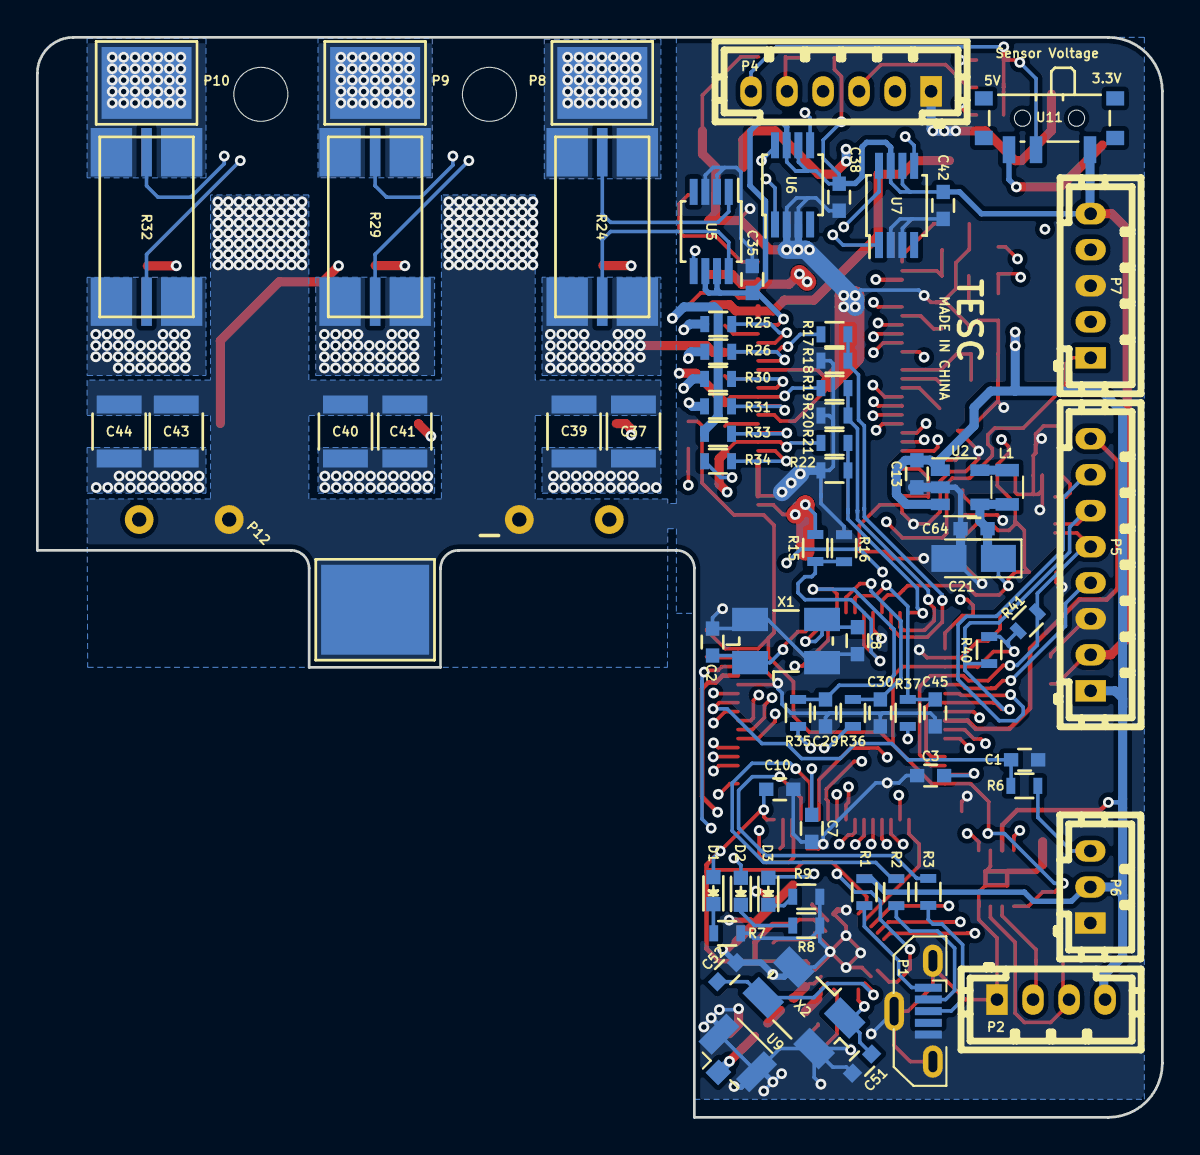
[picture p42: board VESC_6.kicad_pcb from below]

Board: 4 copper layers, 62.5 x 60.0 mm, 146 parts (74 on the bottom side), 116 nets.

Parts:
C1, C7, C28, C48, C49, C50, C53, C58, C60: 100n; C_0603
C2, C8, C51, C52: 15p; C_0603
C3, C4, C5, C6, C9, C10, C11, C12, C13, C14, C15, C17, C20, C31, C33, C34, C35, C36, C38, C42, C59, C61, C62, C63, C64: 2.2u; C_0603
C16: 6.8n; C_0603
C18: 120p; C_0603
C19: 22n; C_0603
C21, C32: 100u; CP_Tantalum_Case-A_EIA-3216-18_Reflow
C22: 15n; C_0603
C23, C24, C25: 220n; C_0603
C26, C27, C37, C39, C40, C41, C43, C44: 4.7u_100V; C_1210
C29, C30, C45: 4.7n; C_0603
C46, C47: 680u_63V; CP_Radial_D12.5mm_P5.00mm
C54: 2.2n; C_0402
C55: 4.7p; C_0402
C56: 1.5p; C_0402
C57: 1p; C_0402
D1: BLUE; LED_0603
D2: RED; LED_0603
D3: GREEN; LED_0603
D4: DIODE; D_SMA
D5: TVS 5V; D_SMA
L1: 2.2u; L_0805
L2: 22u; L_Coilcraft_XAL5050
L3: 8.2n; L_0402
L4: 3.9n; L_0402
L5: 2.7n; L_0402
P1: USB_OTG; USB_Micro-B_Vertical_Molex-105133-0001
P2: CAN; b4b-ph-kl
P4: HALL_ENC; b6b-ph-kl
P5: COM; b8b-ph-kl
P6: SERVO; b3b-ph-kl
P7: SWD; b5b-ph-kl
P8: PH_A; 1PAD_4x5mm
P9: PH_B; 1PAD_4x5mm
P10: PH_C; 1PAD_4x5mm
P11: SUPPLY; 1PAD_6x5mm
P12: GND; 1PAD_6x5mm
Q1, Q2, Q3, Q4, Q5, Q6: IRF7749; DirectFET_L8
R1: 0R; R_0603
R2, R3: 22R; R_0603
R6, R35, R36, R37: 100R; R_0603
R7, R40, R41: 1k; R_0603
R8, R9, R23: 220R; R_0603
R10: 3.3k; R_0603
R11: 18k; R_0603
R12: 15k; R_0603
R13, R28, R39: 10k; R_0603
R14: 220k; R_0603
R15, R17, R19, R21: 39k; R_0603
R16, R18, R20, R22, R42, R43, R44: 2k2; R_0603
R24, R29, R32: 0.0005R; SHUNT_CSS2H-3920
R25, R26, R30, R31, R33, R34: 4.7R; R_0603
R27: NTC 10k; R_0603
R38: 22k; R_0603
U1: STM32F40X_LQFP64; STM32F4x5RG
U2: LM3671; SOT-23-5
U3: DRV8301; TSSOP-56-PP
U4: TJA1051TK3; DFN-8-1EP_3x3mm_Pitch0.65mm
U5, U6, U7: AD8418; MSOP-8_3x3mm_Pitch0.65mm
U8: NRF24L01P; QFN-20-1EP_4x4mm_Pitch0.5mm
U9: CONN_U_FL; U.FL_Hirose_U.FL-R-SMT-1_Vertical
U10: MPU9150; QFN-24_4x4mm_Pitch0.5mm
U11: SENSOR_VOLTAGE; SW_SPDT_PCM12
X1: 8m; Crystal_SMD_5032_4Pads
X2: 16M; Crystal_SMD_5032_4Pads

Connections:
+5V: C13.1, C31.1, C32.1, C33.1, D5.1, L2.2, P2.4, P5.1, P6.2, R1.2, R11.2, U2.1, U2.3, U4.3, U11.3
/CAN/CANH: P2.3, R23.1, U4.7
/CAN/CANL: P2.2, R23.2, U4.6
/DRV8301/CS: U1.40, U3.8
/DRV8301/EN_GATE: U1.57, U3.16
/DRV8301/FAULT: U1.59, U3.6
/DRV8301/GH_A: R25.2, U3.47
/DRV8301/GH_B: R30.2, U3.42
/DRV8301/GH_C: R33.2, U3.37
/DRV8301/GL_A: R26.2, U3.45
/DRV8301/GL_B: R31.2, U3.40
/DRV8301/GL_C: R34.2, U3.35
/DRV8301/INL_A: U1.34, U3.18
/DRV8301/INL_B: U1.35, U3.20
/DRV8301/INL_C: U1.36, U3.22
/DRV8301/SCLK: U1.51, U3.11
/DRV8301/SDI: U1.53, U3.9
/DRV8301/SDO: U1.52, U3.10
/DRV8301/SENS_A: R17.1, R18.1, U1.14
/DRV8301/SENS_B: R19.1, R20.1, U1.15
/DRV8301/SENS_C: R21.1, R22.1, U1.16
/DRV8301/SH_A: C23.2, Q1.S, Q2.D, R17.2, R24.2, U3.46
/DRV8301/SH_B: C24.2, Q3.S, Q4.D, R19.2, R29.2, U3.41
/DRV8301/SH_C: C25.2, Q5.S, Q6.D, R21.2, R32.2, U3.36
/MCU/ADC_15: P5.8, U1.25
/MCU/ADC_TEMP: C36.1, R27.2, R28.1, U1.17
/MCU/AI_IN: R15.1, R16.1, U1.11
/MCU/CAN_RX: U1.61, U4.4
/MCU/CAN_TX: U1.62, U4.1
/MCU/CURRENT_1: C29.1, R35.2, U1.8
/MCU/CURRENT_2: C30.1, R36.2, U1.9
/MCU/CURRENT_3: C45.1, R37.2, U1.10
/MCU/H1: U1.41, U3.17
/MCU/H2: U1.42, U3.19
/MCU/H3: U1.43, U3.21
/MCU/HALL_1: P4.4, R42.1, U1.37
/MCU/HALL_2: P4.3, R43.1, U1.38
/MCU/HALL_3: P4.2, R44.1, U1.39
/MCU/LED_GREEN: D3.2, U1.26
/MCU/LED_RED: D2.2, U1.27
/MCU/MISO_ADC_EXT2: P5.7, U1.22
/MCU/NRST: C7.1, P7.1, U1.7
/MCU/PB4: U1.56, U8.3
/MCU/RX_SDA_NSS: P5.5, R41.2, U1.20, U1.30, U10.24
/MCU/SCK_ADC_EXT: P5.4, U1.21
/MCU/SERVO: C1.1, R6.1, U1.58
/MCU/SWCLK: P7.4, U1.49
/MCU/SWDIO: P7.2, U1.46
/MCU/TEMP_MOTOR: C58.1, P4.5, R39.1, U1.24
/MCU/USB_DM: R2.1, U1.44
/MCU/USB_DP: R3.1, U1.45
/MPU9150/SCL: P5.6, R40.2, U1.23, U1.29, U10.23
/Power/C_A: R35.1, U5.5
/Power/C_B: R36.1, U6.5
/Power/C_C: R37.1, U7.5
/nrf/CSN: U1.33, U8.2
/nrf/MISO: U1.54, U8.5
/nrf/MOSI: U1.55, U8.4
GND: C1.2, C2.1, C3.1, C4.1, C5.2, C6.2, C7.2, C8.1, C9.2, C10.2, C11.2, C12.2, C13.2, C14.2, C15.2, C16.1, C17.2, C18.1, C20.2, C21.2, C22.2, C26.2, C27.2, C29.2, C30.2, C31.2, C32.2, C33.2, C34.2, C35.2, C36.2, C37.2, C38.2, C39.2, C40.2, C41.2, C42.2, C43.2, C44.2, C45.2, C46.2, C47.2, C48.2, C49.1, C50.2, C51.1, C52.1, C53.2, C54.2, C55.2, C57.2, C58.2, C59.1, C60.1, C61.2, C62.2, C63.2, C64.2, D4.2, D5.2, P1.5, P1.6, P2.1, P4.1, P5.3, P6.1, P7.3, P12.1, Q2.S, Q4.S, Q6.S, R7.1, R8.1, R9.1, R10.1, R13.1, R14.1, R16.2, R18.2, R20.2, R22.2, R28.2, R38.1, U1.12, U1.18, U1.60, U1.63, U2.2, U3.28, U3.30, U3.31, U3.32, U3.33, U3.34, U3.39, U3.44, U3.57, U4.2, U4.8, U4.9, U5.2, U5.3, U6.2, U6.3, U7.2, U7.3, U8.8, U8.14, U8.17, U8.20, U8.21, U9.2, U10.9, U10.15, U10.17, U10.18, X1.3, X2.3
unnamed: C2.2, U1.5, X1.1
unnamed: C3.2, U1.31
unnamed: C4.2, U1.47
unnamed: C8.2, U1.6, X1.2
unnamed: C14.1, C15.1, U3.13
unnamed: C16.2, R12.1
unnamed: C17.1, U3.23
unnamed: C18.2, R12.2, U3.2
unnamed: C19.1, U3.14
unnamed: C19.2, U3.15
unnamed: C20.1, U3.24, U3.27
unnamed: C22.1, U3.56
unnamed: C23.1, U3.48
unnamed: C24.1, U3.43
unnamed: C25.1, U3.38
unnamed: C28.1, U3.52
unnamed: C28.2, D4.1, L2.1, U3.50, U3.51
unnamed: C49.2, U8.19
unnamed: C51.2, U8.10, X2.1
unnamed: C52.2, U8.9, X2.2
unnamed: C54.1, C55.1, L5.1, U8.11
unnamed: C56.1, C57.1, U9.1
unnamed: C56.2, L4.1
unnamed: C59.2, U10.10
unnamed: C60.2, U10.20
unnamed: D1.1, R7.2
unnamed: D2.1, R8.2
unnamed: D3.1, R9.2
unnamed: L1.1, U2.5
unnamed: L3.1, L4.2, U8.13
unnamed: L3.2, L5.2, U8.12
unnamed: P1.1, R1.1
unnamed: P1.2, R2.2
unnamed: P1.3, R3.2
unnamed: P4.6, R42.2, R43.2, R44.2, U11.2
unnamed: P6.3, R6.2
unnamed: P8.1, R24.1
unnamed: P9.1, R29.1
unnamed: P10.1, R32.1
unnamed: Q1.G, R25.1
unnamed: Q2.G, R26.1
unnamed: Q3.G, R30.1
unnamed: Q4.G, R31.1
unnamed: Q5.G, R33.1
unnamed: Q6.G, R34.1
unnamed: R10.2, R11.1, U3.3
unnamed: R13.2, U3.7
unnamed: R14.2, U3.1
unnamed: R24.3, U5.1
unnamed: R24.4, U5.8
unnamed: R29.3, U6.1
unnamed: R29.4, U6.8
unnamed: R32.3, U7.1
unnamed: R32.4, U7.8
unnamed: R38.2, U8.16
SUPPLY: C26.1, C27.1, C37.1, C39.1, C40.1, C41.1, C43.1, C44.1, C46.1, C47.1, P11.1, Q1.D, Q3.D, Q5.D, R15.2, U3.29, U3.53, U3.54
VCC: C5.1, C6.1, C9.1, C10.1, C11.1, C12.1, C21.1, C34.1, C35.1, C38.1, C42.1, C48.1, C50.1, C53.1, C61.1, C62.1, C63.1, C64.1, D1.2, L1.2, P5.2, P7.5, R27.1, R39.2, R40.1, R41.1, U1.1, U1.13, U1.19, U1.32, U1.48, U1.64, U2.4, U3.49, U4.5, U5.6, U5.7, U6.6, U6.7, U7.6, U7.7, U8.1, U8.7, U8.15, U8.18, U10.3, U10.8, U10.13, U11.1
