darwinbeing/tesc/(commit log)

2018-04-05 initial commit -m
    [CAN.sch, DRV8301.sch, MCU.sch, Power.sch, VESC_6.kicad_pcb, VESC_6.sch, mpu9150.sch, nrf.sch]
2018-04-07 dimension 60X60
    [VESC_6.kicad_pcb]
2018-04-13 Cleanup Tracks and Vias
    [VESC_6.kicad_pcb]
2018-04-21 Prepare version 1.0
    [VESC_6-B.Cu.gbl, VESC_6-B.Mask.gbs, VESC_6-B.Paste.gbp, VESC_6-B.SilkS.gbo, VESC_6-Edge.Cuts.gm1, VESC_6-F.Cu.gtl, VESC_6-F.Mask.gts, VESC_6-F.Paste.gtp]
2018-04-27 TESC 1.0
    [VESC_6-B.Cu.gbl, VESC_6-B.Mask.gbs, VESC_6-B.Paste.gbp, VESC_6-B.SilkS.gbo, VESC_6-Edge.Cuts.gm1, VESC_6-F.Cu.gtl, VESC_6-F.Mask.gts, VESC_6-F.Paste.gtp]
2018-04-30 TESC 1.1
    [VESC_6-B.Cu.gbl, VESC_6-B.Mask.gbs, VESC_6-B.Paste.gbp, VESC_6-B.SilkS.gbo, VESC_6-Edge.Cuts.gm1, VESC_6-F.Cu.gtl, VESC_6-F.Mask.gts, VESC_6-F.Paste.gtp]
2018-05-01 Add polarity direction silk screen
    [VESC_6.kicad_pcb]
2018-05-01 TESC 1.2
    [VESC_6-B.Cu.gbl, VESC_6-B.Mask.gbs, VESC_6-B.Paste.gbp, VESC_6-B.SilkS.gbo, VESC_6-Edge.Cuts.gm1, VESC_6-F.Cu.gtl, VESC_6-F.Mask.gts, VESC_6-F.Paste.gtp]
2018-05-04 TESC 1.3
    [VESC_6-B.Cu.gbl, VESC_6-B.Mask.gbs, VESC_6-B.Paste.gbp, VESC_6-B.SilkS.gbo, VESC_6-Edge.Cuts.gm1, VESC_6-F.Cu.gtl, VESC_6-F.Mask.gts, VESC_6-F.Paste.gtp]
2018-05-05 TESC 1.4
    [CAN.sch, DRV8301.sch, MCU.sch, Power.sch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]
2018-05-05 Make Loops Small
    [VESC_6.kicad_pcb]
2018-05-06 Add manf# field
    [CAN.sch, DRV8301.sch, MCU.sch, Power.sch, VESC_6.sch, VESC_6.xml, mpu9150.sch, nrf.sch]
2018-05-06 TESC Release
    [VESC_6-B.Cu.gbl, VESC_6-B.Mask.gbs, VESC_6-B.Paste.gbp, VESC_6-B.SilkS.gbo, VESC_6-Edge.Cuts.gm1, VESC_6-F.Cu.gtl, VESC_6-F.Mask.gts, VESC_6-F.Paste.gtp]
2018-05-06 Change silk screen
    [VESC_6-B.Cu.gbl, VESC_6-B.Mask.gbs, VESC_6-B.Paste.gbp, VESC_6-B.SilkS.gbo, VESC_6-Edge.Cuts.gm1, VESC_6-F.Cu.gtl, VESC_6-F.Mask.gts, VESC_6-F.Paste.gtp]
2018-05-06 Optimize copper ground pour
    [VESC_6-B.Cu.gbl, VESC_6-B.Mask.gbs, VESC_6-B.Paste.gbp, VESC_6-B.SilkS.gbo, VESC_6-Edge.Cuts.gm1, VESC_6-F.Cu.gtl, VESC_6-F.Mask.gts, VESC_6-F.Paste.gtp]
2018-05-07 Change U11 silk screen
    [VESC_6.kicad_pcb]
2018-05-07 Optimize trace
    [VESC_6-B.Cu.gbl, VESC_6-B.Mask.gbs, VESC_6-B.Paste.gbp, VESC_6-B.SilkS.gbo, VESC_6-Edge.Cuts.gm1, VESC_6-F.Cu.gtl, VESC_6-F.Mask.gts, VESC_6-F.Paste.gtp]
2018-05-08 SHUNT_CSS2H-3920: add silk screen
    [VESC_6.kicad_pcb]
2018-05-08 Add mpu9250 impl
    [CAN.sch, DRV8301.sch, MCU.sch, Power.sch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]
2018-05-08 Regenerate Gerber
    [VESC_6.kicad_pcb, VESC_6.xml, mpu9250.sch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]
2018-05-08 MPU9250: add part number field
    [mpu9250.sch]
2018-05-10 Change all via size
    [VESC_6-B.Cu.gbl, VESC_6-B.Mask.gbs, VESC_6-B.Paste.gbp, VESC_6-B.SilkS.gbo, VESC_6-Edge.Cuts.gm1, VESC_6-F.Cu.gtl, VESC_6-F.Mask.gts, VESC_6-F.Paste.gtp]
2018-05-11 Add TESC_HandSoldering.xlsx
    [TESC_HandSoldering.xlsx]
2018-05-13 Add CSS2H-3920 3D model
    [VESC_6-B.Cu.gbl, VESC_6-B.Mask.gbs, VESC_6-B.Paste.gbp, VESC_6-B.SilkS.gbo, VESC_6-Edge.Cuts.gm1, VESC_6-F.Cu.gtl, VESC_6-F.Mask.gts, VESC_6-F.Paste.gtp]
2018-05-14 Optimize track
    [VESC_6.kicad_pcb]
2018-05-14 Optimize silks
    [VESC_6-B.Cu.gbl, VESC_6-B.Mask.gbs, VESC_6-B.Paste.gbp, VESC_6-B.SilkS.gbo, VESC_6-Edge.Cuts.gm1, VESC_6-F.Cu.gtl, VESC_6-F.Mask.gts, VESC_6-F.Paste.gtp]
2018-05-17 Update silk screen
    [VESC_6.kicad_pcb]
2018-05-20 Optimize silk screen & track
    [VESC_6-B.Cu.gbl, VESC_6-B.Mask.gbs, VESC_6-B.Paste.gbp, VESC_6-B.SilkS.gbo, VESC_6-Edge.Cuts.gm1, VESC_6-F.Cu.gtl, VESC_6-F.Mask.gts, VESC_6-F.Paste.gtp]
2018-05-21 Add visual diff scripts Kicad on OSX/Windows doesn't support python api
2018-05-21 Update track, copper pour
    [VESC_6-B.Cu.gbl, VESC_6-B.Mask.gbs, VESC_6-B.Paste.gbp, VESC_6-B.SilkS.gbo, VESC_6-Edge.Cuts.gm1, VESC_6-F.Cu.gtl, VESC_6-F.Mask.gts, VESC_6-F.Paste.gtp]
2018-05-21 Optimize silk screen
    [VESC_6-B.Cu.gbl, VESC_6-B.Mask.gbs, VESC_6-B.Paste.gbp, VESC_6-B.SilkS.gbo, VESC_6-Edge.Cuts.gm1, VESC_6-F.Cu.gtl, VESC_6-F.Mask.gts, VESC_6-F.Paste.gtp]
2018-05-23 Add Gerber.zip
2018-05-27 Generate gerber files
    [VESC_6-B.Cu.gbl, VESC_6-B.Mask.gbs, VESC_6-B.Paste.gbp, VESC_6-B.SilkS.gbo, VESC_6-Edge.Cuts.gm1, VESC_6-F.Cu.gtl, VESC_6-F.Mask.gts, VESC_6-F.Paste.gtp]
2018-05-28 Update silks, re-generate gerber files
    [VESC_6-B.Cu.gbl, VESC_6-B.Mask.gbs, VESC_6-B.Paste.gbp, VESC_6-B.SilkS.gbo, VESC_6-Edge.Cuts.gm1, VESC_6-F.Cu.gtl, VESC_6-F.Mask.gts, VESC_6-F.Paste.gtp]
2018-05-28 Update silks
    [VESC_6.kicad_pcb]
2018-05-28 Optimize layout
    [VESC_6.kicad_pcb]
2018-05-28 Optimize layout, generate gerber files
    [VESC_6-B.Cu.gbl, VESC_6-B.Mask.gbs, VESC_6-B.Paste.gbp, VESC_6-B.SilkS.gbo, VESC_6-Edge.Cuts.gm1, VESC_6-F.Cu.gtl, VESC_6-F.Mask.gts, VESC_6-F.Paste.gtp]
2018-05-29 Zip gerber files
    [VESC_6-B.Cu.gbl, VESC_6-B.Mask.gbs, VESC_6-B.Paste.gbp, VESC_6-B.SilkS.gbo, VESC_6-Edge.Cuts.gm1, VESC_6-F.Cu.gtl, VESC_6-F.Mask.gts, VESC_6-F.Paste.gtp]
2018-05-29 Add gerber zip file
2018-05-29 Update hand soldering pdf
2018-06-02 Optimize track, rearrange NRF module
    [VESC_6.kicad_pcb]
2018-06-15 Add OpenSCAD Tutorial
    [2016-04-23_FNQ220_Flix_v24.scad, VESC_6.scad, t1.scad, t2.scad, t3.scad]
2018-06-18 Update Project Enclosure,VESC Case/Lid
    [VESC_6.scad, VESC_6.stl, roundedcube.scad, screw_holes.scad, speakerrings.scad, t4.scad]
2018-07-15 Update PCB
    [VESC_6.kicad_pcb]
2018-10-23 Change layout
    [VESC_6.kicad_pcb]
2019-11-12 Support KiCad 5.1.4
    [CAN.sch, DRV8301.sch, MCU.sch, Power.sch, VESC_6.kicad_pcb, VESC_6.sch, mpu9250.sch, nrf.sch]
2019-11-13 Improve layout
    [VESC_6.kicad_pcb]
2019-11-15 Load KiCad 4.0.7 schematic symbols, footprints & 3D models
    [CAN.sch, DRV8301.sch, MCU.sch, Power.sch, VESC_6.kicad_pcb, VESC_6.sch, VESC_6.xml, mpu9250.sch]
2019-11-15 Add ICM-20948 support
    [DRV8301.sch, VESC_6.kicad_pcb, VESC_6.sch, icm20948.sch]
2019-11-15 Revert "Add ICM-20948 support"
    This reverts commit 6973a9f76e2e1207f1c7879789cf7605503054ef.
    [DRV8301.sch, VESC_6.kicad_pcb, VESC_6.sch, icm20948.sch]
2019-11-16 Generate Gerber and Drill files from KiCad to produce the PCB boards
    [VESC_6-B_Cu.gbl, VESC_6-B_Mask.gbs, VESC_6-B_Paste.gbp, VESC_6-B_SilkS.gbo, VESC_6-Edge_Cuts.gm1, VESC_6-F_Cu.gtl, VESC_6-F_Mask.gts, VESC_6-F_Paste.gtp]
2019-11-17 Cleanup Tracks
    [VESC_6.kicad_pcb]
2019-11-17 Update layout
    [VESC_6.kicad_pcb]
2019-11-18 Lock mounting hole footprint, modify the pad name of directFET
    [VESC_6.kicad_pcb]
2019-11-21 Update part number
    [nrf.sch]
2019-11-21 remove VESC_6.xml
    [VESC_6.xml]
2019-11-23 Update LEDs silkscreen
    [VESC_6.kicad_pcb]
2019-12-03 Update Fabrication Attributes
    [VESC_6.kicad_pcb]
2019-12-07 Change Clearance of copper pours of net SUPPLY
    [VESC_6.kicad_pcb]
2019-12-07 remove text
    [VESC_6.kicad_pcb]
2019-12-07 Cleanup silkscreen
    [VESC_6.kicad_pcb]
2019-12-08 Add pcbnew script
2019-12-11 Enable MPU-9150
    [VESC_6.kicad_pcb, VESC_6.sch, mpu9150.sch]
2019-12-12 remove VESC_6.net
2019-12-16 Revert "Update layout"
    This reverts commit 6f6561b38768be4a724b66136c09b621815d8cf7.
    [VESC_6.kicad_pcb]
2019-12-18 Generate Gerber and drill files in RS-274x format
    [VESC_6-B_Cu.gbl, VESC_6-B_Mask.gbs, VESC_6-B_Paste.gbp, VESC_6-B_SilkS.gbo, VESC_6-Edge_Cuts.gm1, VESC_6-F_Cu.gtl, VESC_6-F_Mask.gts, VESC_6-F_Paste.gtp]
2019-12-21 Update C2/C8/C51/C52 BOM(06035A150GAT2A)
    [CAN.sch, DRV8301.sch, MCU.sch, Power.sch, VESC_6.sch, mpu9150.sch, nrf.sch]
2019-12-25 Correct Mounting Hole Attribute
    [VESC_6.kicad_pcb]
2019-12-28 tent vias
    [VESC_6-B_Cu.gbl, VESC_6-B_Mask.gbs, VESC_6-B_Paste.gbp, VESC_6-B_SilkS.gbo, VESC_6-Edge_Cuts.gm1, VESC_6-F_Cu.gtl, VESC_6-F_Mask.gts, VESC_6-F_Paste.gtp]
2024-06-09 Upload VESC 6 3D images
